alustig3/kicad-libraries/3d/CAS-D20TB.stp

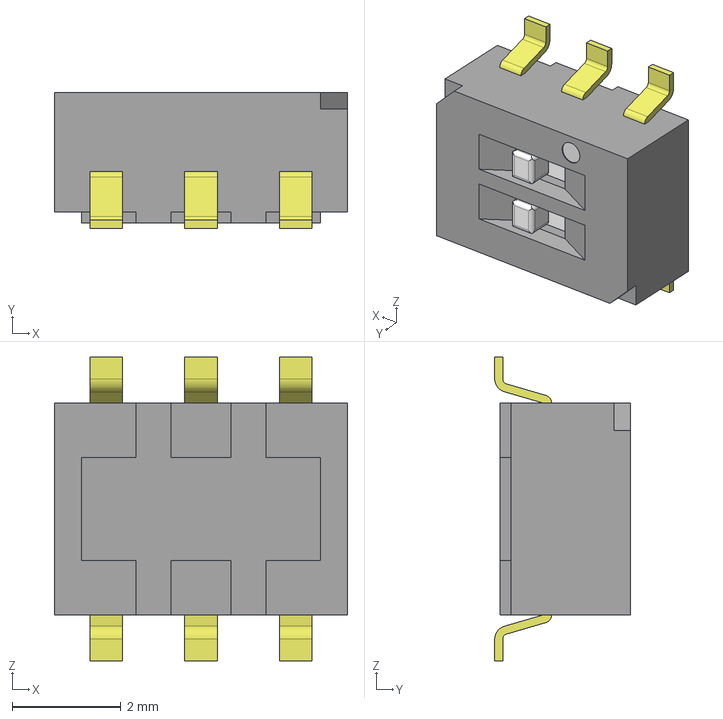
[picture p1: CAD file, 2026-10-02]
3d/CAS-D20TB.stp
5.40 x 2.50 x 5.60 mm
CAS_c_D2B
Dual_s x 2
