alustig3/kicad-libraries/3d/KMR621NGLFS.step

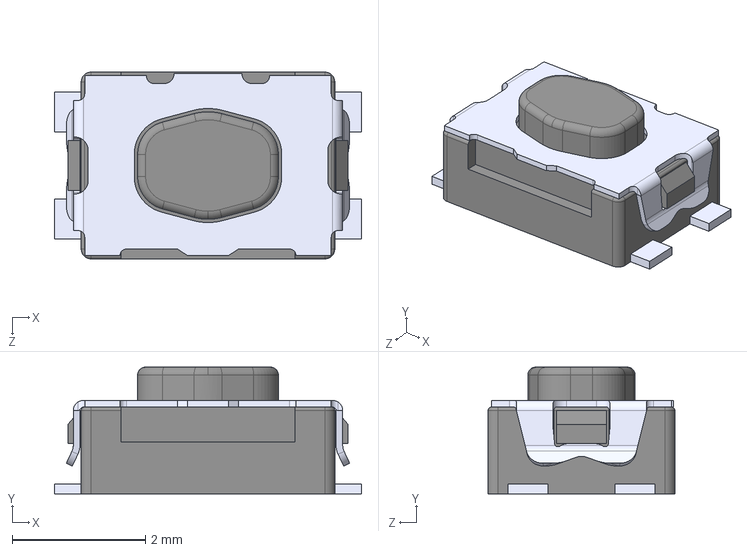
[picture p2: CAD file, 2026-09-30]
3d/KMR621NGLFS.step
4.60 x 1.90 x 2.80 mm
