alustig3/kicad-libraries/3d/7790.step

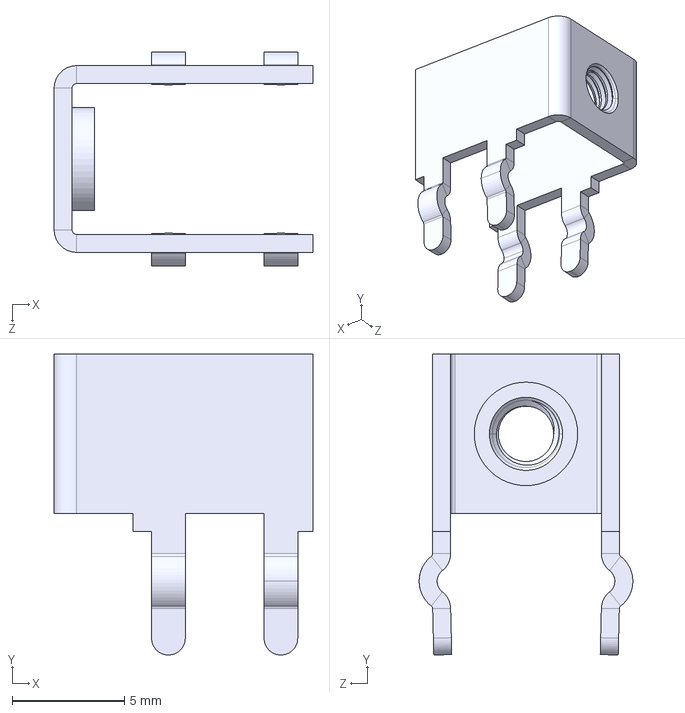
[picture p3: CAD file, 2026-08-19]
3d/7790.step
11.5 x 13.4 x 9.50 mm
