alustig3/kicad-libraries/3d/RA_toggle.step

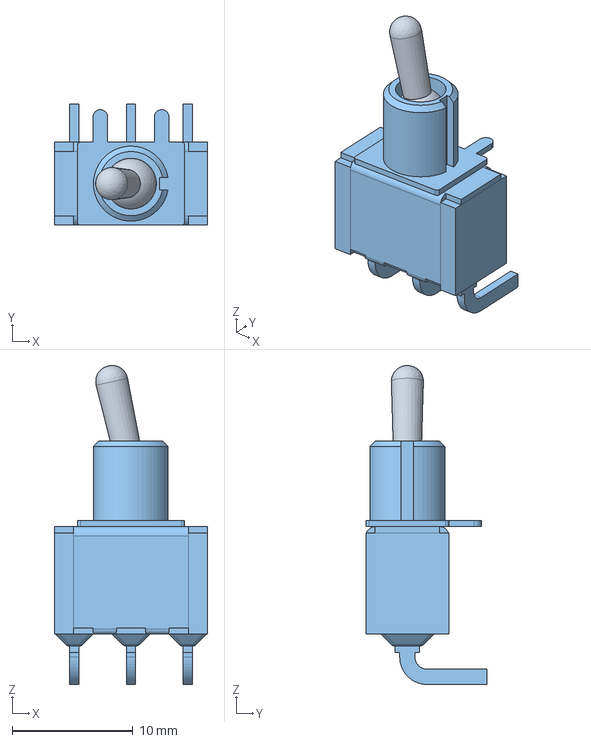
[picture p4: CAD file, 2026-08-18]
3d/RA_toggle.step
12.7 x 10.0 x 26.4 mm
