alustig3/kicad-libraries/3d/TSR 3-2450N.STEP

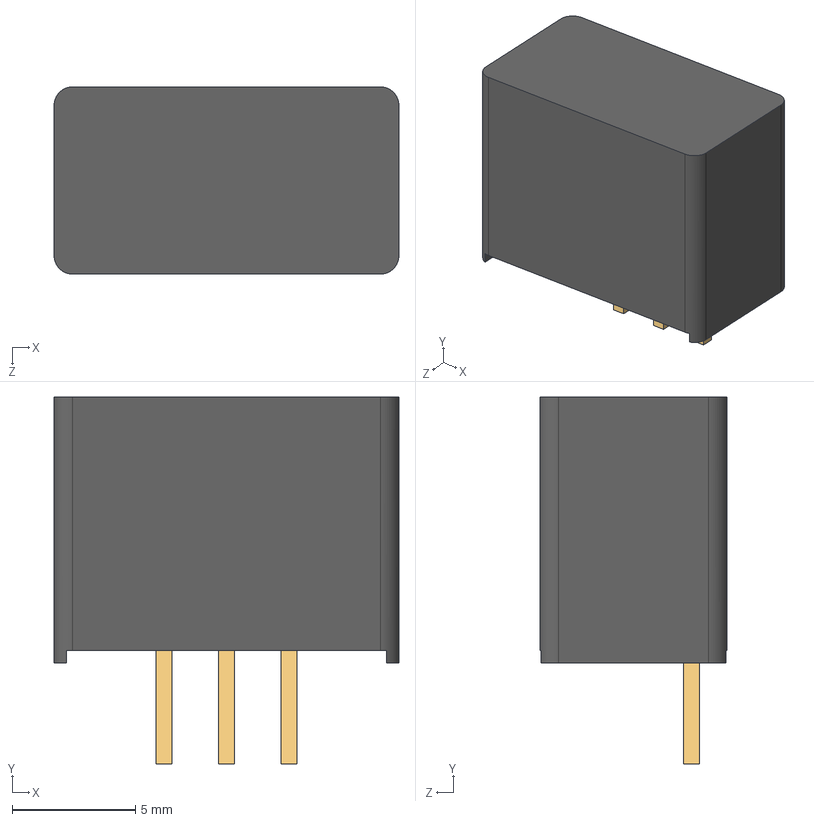
[picture p5: CAD file, 2026-08-18]
3d/TSR 3-2450N.STEP
14.0 x 14.9 x 7.60 mm
CASE-00.stp
__-00.stp
PIN-00.stp x 3
