alustig3/kicad-libraries/3d/W25Q256JVEIQ.STEP

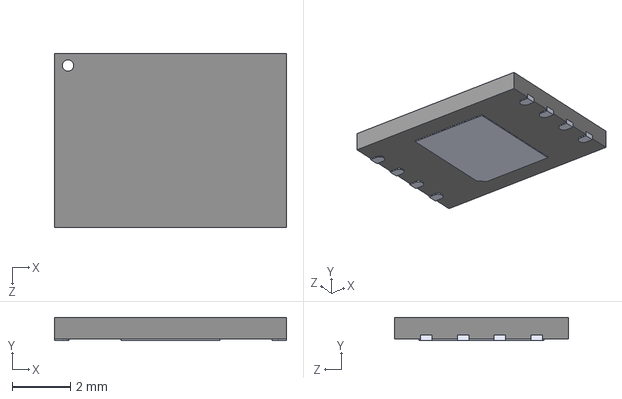
[picture p6: CAD file, 2026-08-05]
3d/W25Q256JVEIQ.STEP
8.00 x 0.8 x 6.00 mm
