alustig3/kicad-libraries/3d/5019.STEP

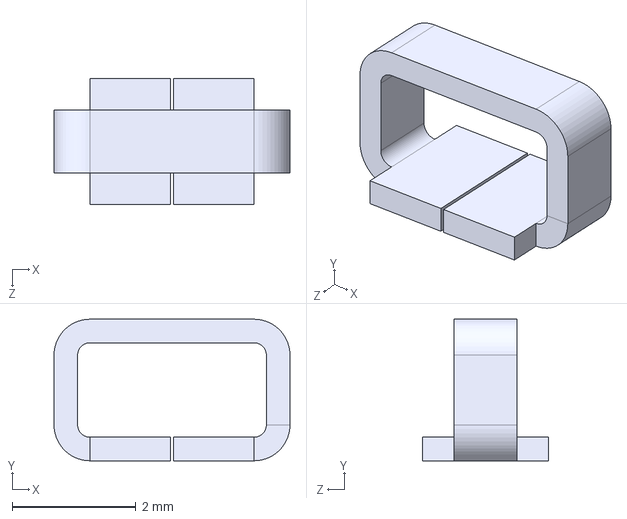
[picture p7: CAD file, 2026-07-16]
3d/5019.STEP
3.81 x 2.29 x 2.03 mm
