alustig3/kicad-libraries/3d/TS02-66-170-BK-260-LCR-D.step

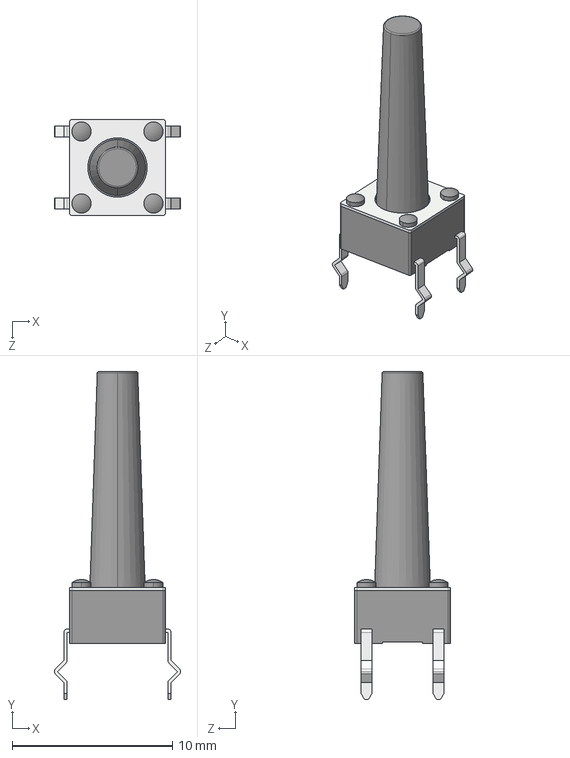
[picture p8: CAD file, 2026-07-08]
3d/TS02-66-170-BK-260-LCR-D.step
7.90 x 20.5 x 6.00 mm
