alustig3/kicad-libraries/3d/RFPC-SMA27-F.step

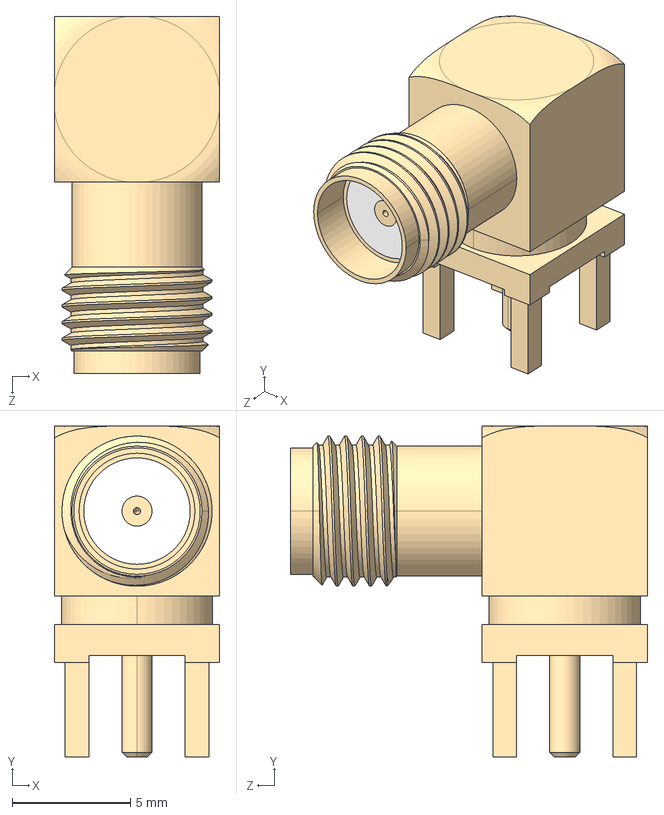
[picture p9: CAD file, 2026-03-03]
3d/RFPC-SMA27-F.step
7.00 x 14.0 x 15.1 mm
