alustig3/kicad-libraries/3d/USB-B1HSB6.STEP

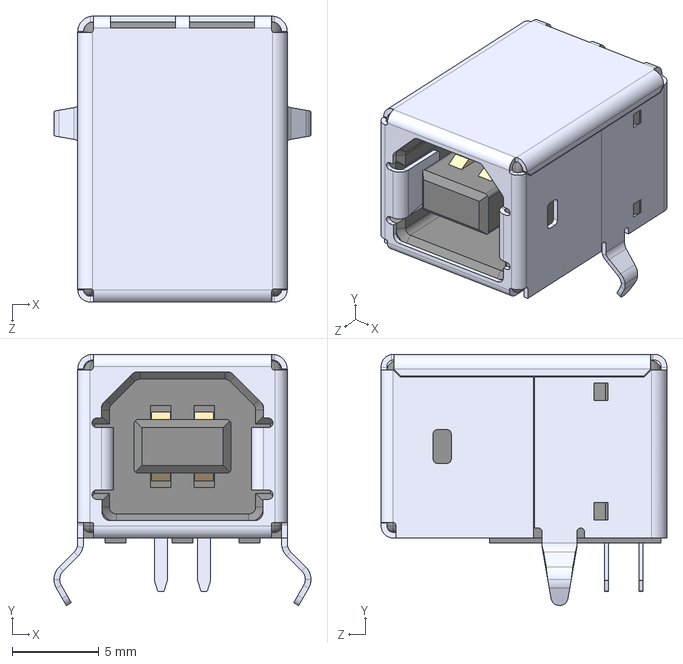
[picture p10: CAD file, 2025-12-22]
3d/USB-B1HSB6.STEP
14.8 x 14.5 x 16.5 mm
