alustig3/kicad-libraries/3d/RJ45_vertical.step

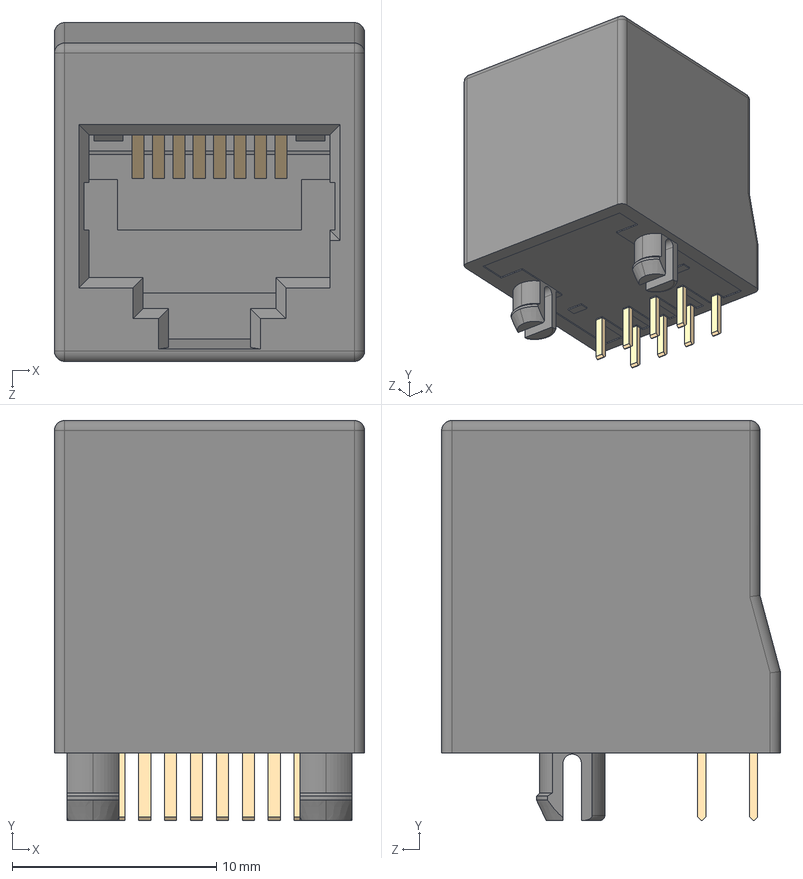
[picture p11: CAD file, 2025-06-04]
3d/RJ45_vertical.step
15.2 x 19.6 x 16.6 mm
