alustig3/kicad-libraries/3d/header_male_16pin.stp

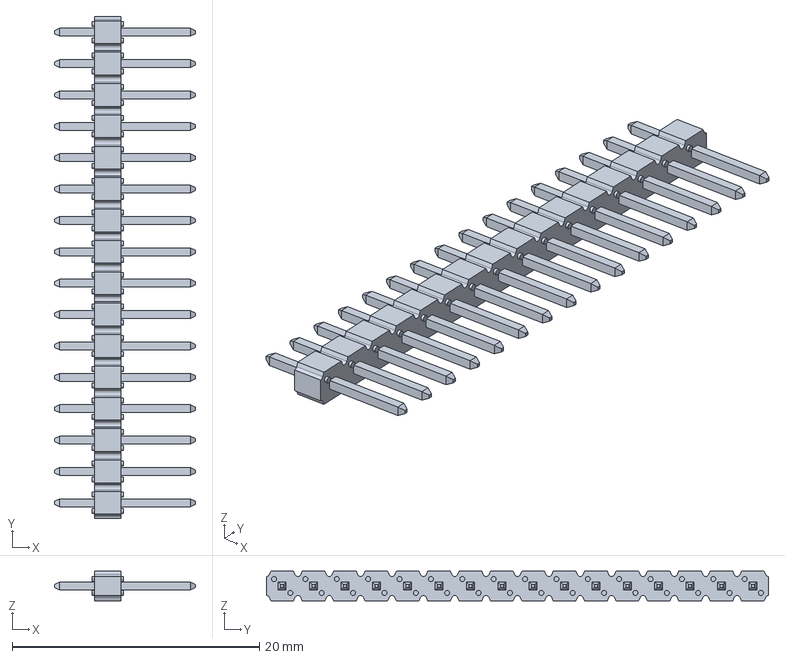
[picture p12: CAD file, 2024-12-18]
3d/header_male_16pin.stp
11.4 x 40.6 x 2.41 mm
