alustig3/kicad-libraries/3d/header_male_10pin.stp

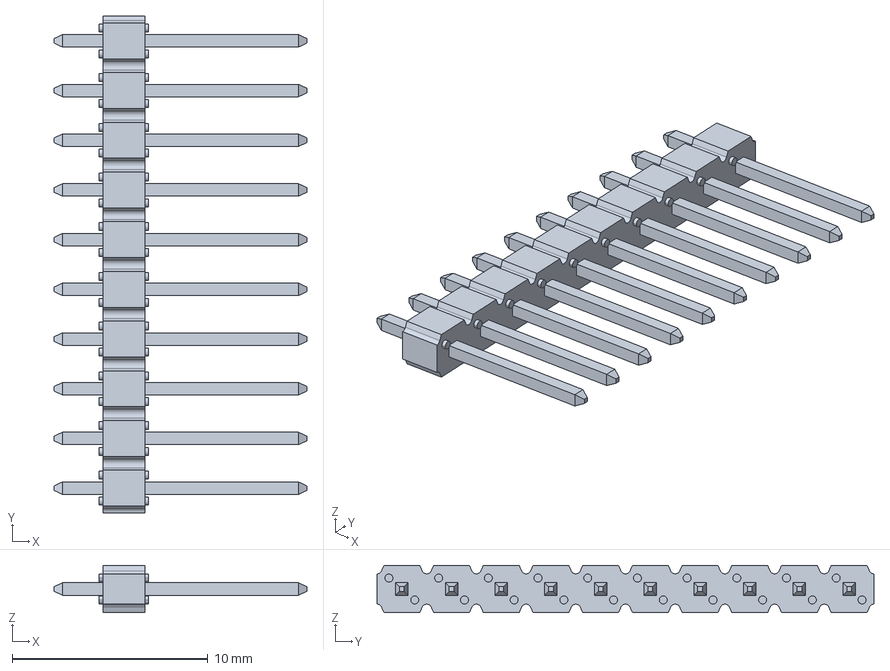
[picture p13: CAD file, 2024-12-18]
3d/header_male_10pin.stp
12.9 x 25.4 x 2.41 mm
