alustig3/kicad-libraries/3d/header_female_10pos.STEP

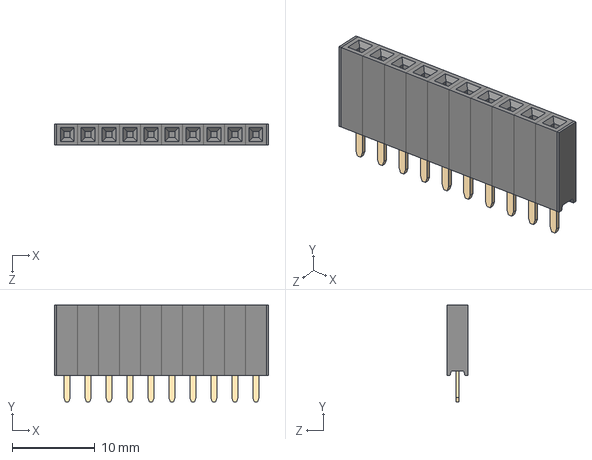
[picture p14: CAD file, 2024-12-18]
3d/header_female_10pos.STEP
25.9 x 11.7 x 2.54 mm
PPPC021LFBN-RC_C10
Pin - Gold x 10
