alustig3/kicad-libraries/3d/header_female_16pos.STEP

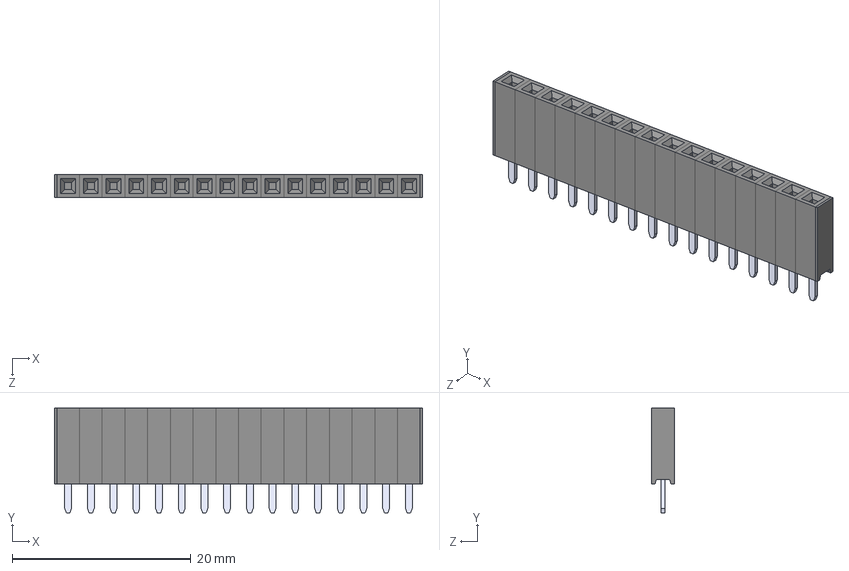
[picture p15: CAD file, 2024-12-18]
3d/header_female_16pos.STEP
41.1 x 11.7 x 2.54 mm
PPPC021LFBN-RC_C16
Pin - Tin x 16
