alustig3/kicad-libraries/3d/CP2102N-A02-GQFN20R.step

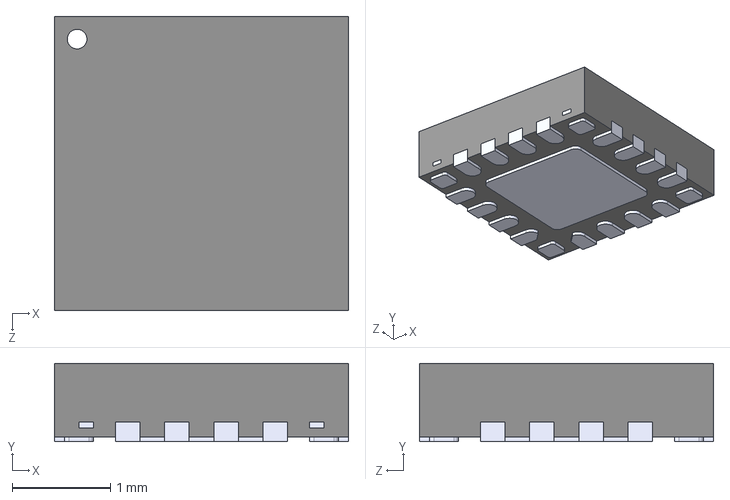
[picture p16: CAD file, 2024-12-13]
3d/CP2102N-A02-GQFN20R.step
3.00 x 0.8 x 3.00 mm
