alustig3/kicad-libraries/3d/s3_reverse_tft_feather.step

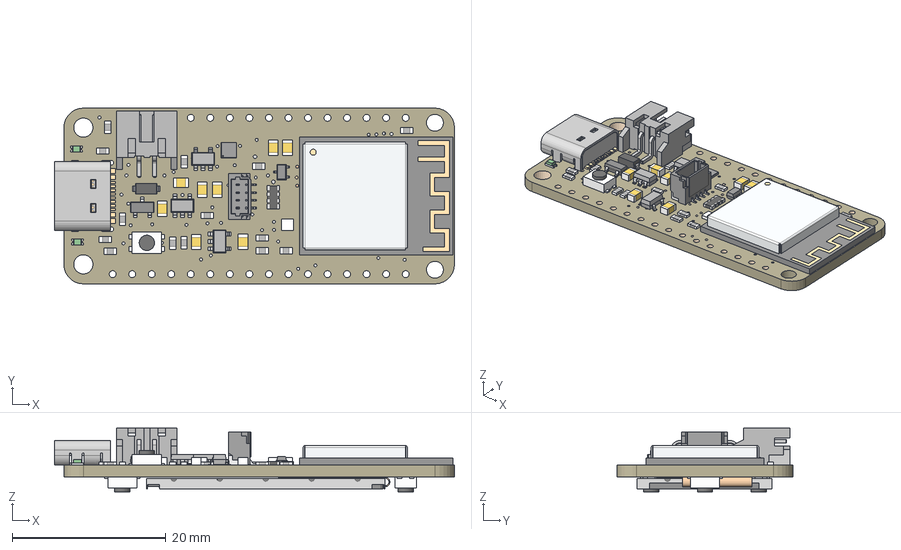
[picture p17: CAD file, 2024-10-28]
3d/s3_reverse_tft_feather.step
52.0 x 22.9 x 8.27 mm
Board
10uF x 8
RT9080/AP2112-3.3 x 2
MBR540
JSTPH
MCP73831T-2ACI/OT
RED x 2
1uF x 14
KMR2 x 5
DMG3415U
USB C
ESP32-S3-MINI-1
STEMMA_I2C_QTRA
WS2812B_SK6805_1515
DISP_LCD_GENERIC_SPI_1.14IN_240X135_WRAPUNDER
BSS138
10K Pack
MAX17048/T
