alustig3/kicad-libraries/3d/S6B-PH-SM4-TB.STEP

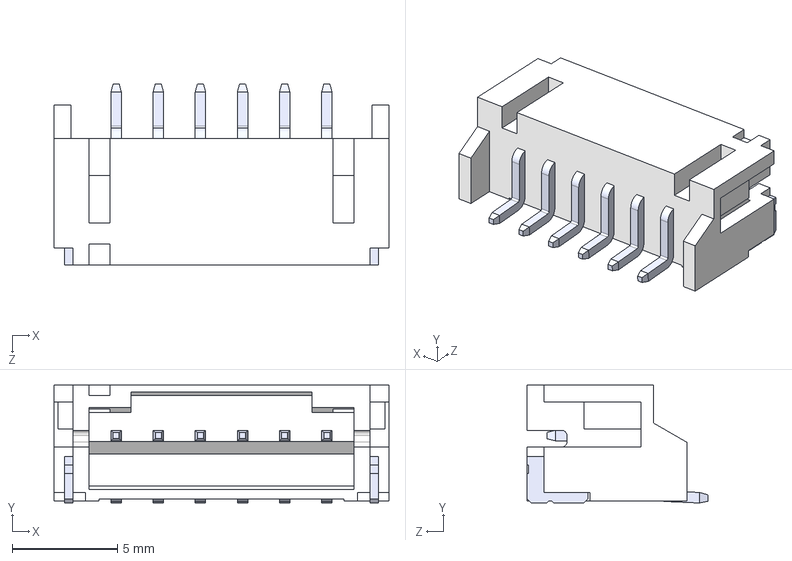
[picture p18: CAD file, 2024-09-23]
3d/S6B-PH-SM4-TB.STEP
15.9 x 5.60 x 8.60 mm
