alustig3/kicad-libraries/3d/B6B-PH-SM4-TB.step

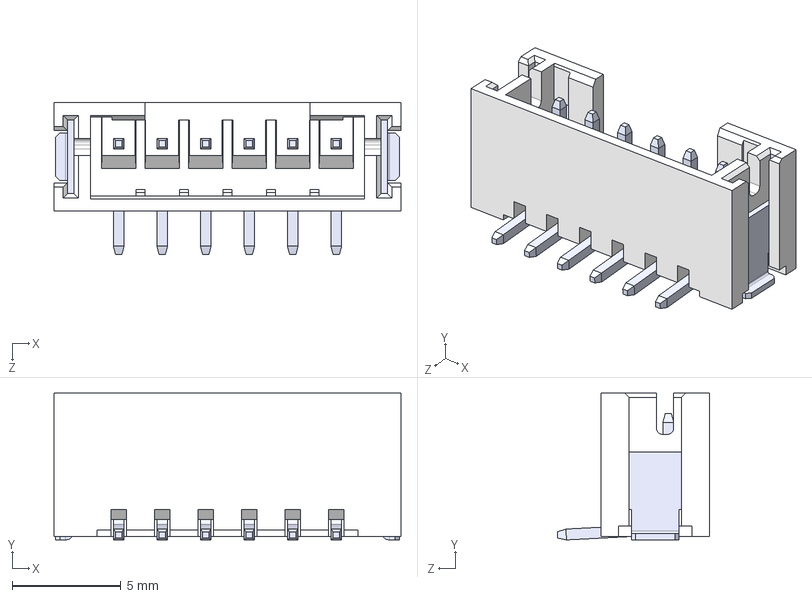
[picture p19: CAD file, 2024-09-03]
3d/B6B-PH-SM4-TB.step
15.9 x 6.75 x 7.00 mm
BxB-PH-SM4 body_6
BxB-PH-SM4 tab x 2
BxB-PH-SM4 pin x 6
