alustig3/kicad-libraries/3d/LBA716STR.step

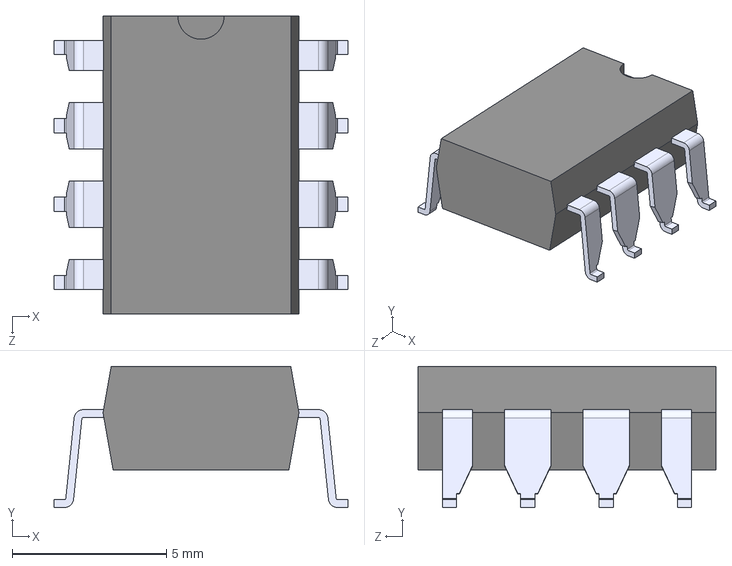
[picture p20: CAD file, 2024-08-30]
3d/LBA716STR.step
9.53 x 4.57 x 9.65 mm
