alustig3/kicad-libraries/3d/E5J88-00LJG2-L.stp

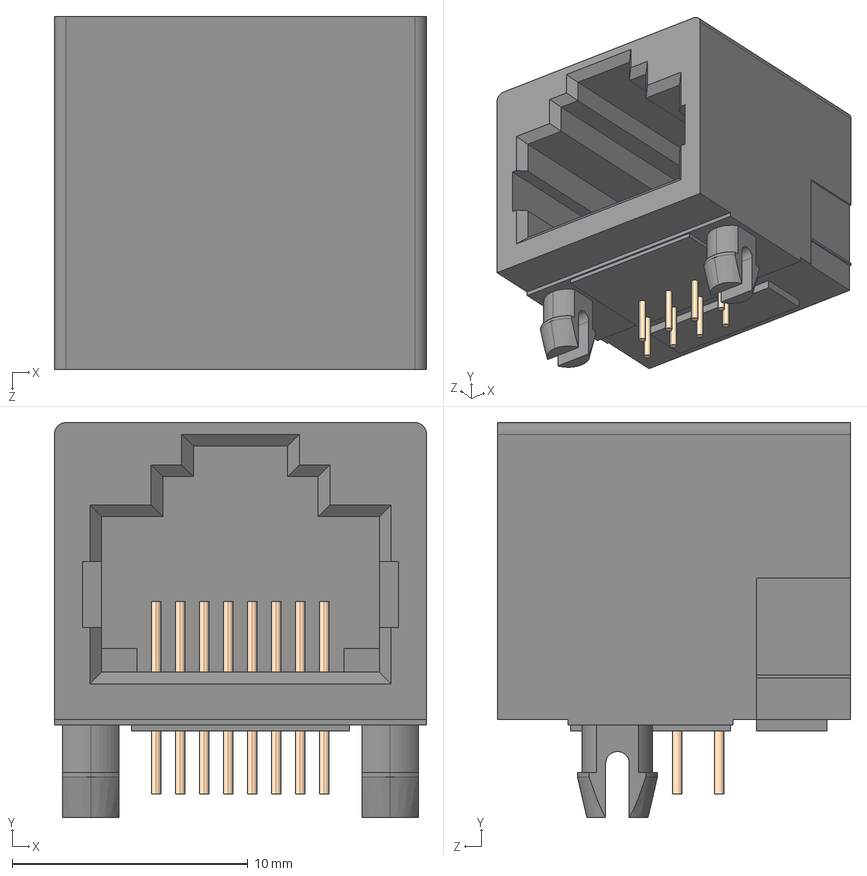
[picture p21: CAD file, 2024-08-30]
3d/E5J88-00LJG2-L.stp
15.8 x 16.8 x 15.0 mm
