alustig3/kicad-libraries/3d/3-2106431-4.step

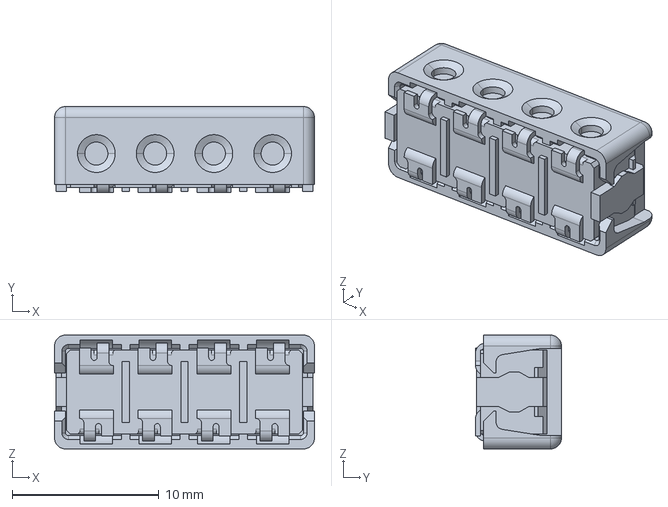
[picture p22: CAD file, 2024-07-26]
3d/3-2106431-4.step
17.7 x 5.85 x 7.75 mm
