alustig3/kicad-libraries/3d/ESE-22MV21T.step

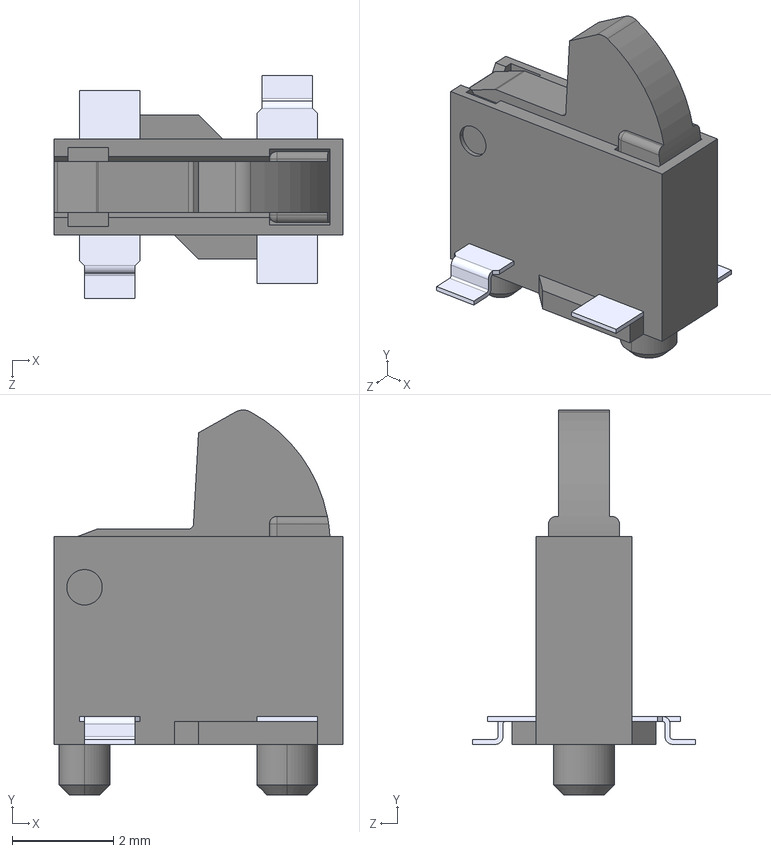
[picture p23: CAD file, 2024-07-18]
3d/ESE-22MV21T.step
5.70 x 7.60 x 4.40 mm
