alustig3/kicad-libraries/3d/SS-641010-A-NF-A111.stp

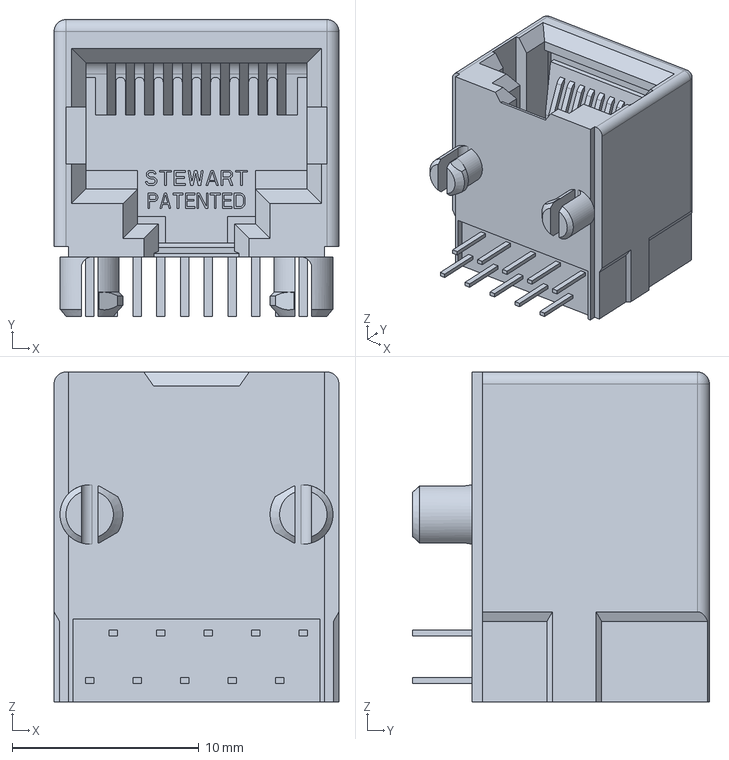
[picture p24: CAD file, 2024-06-14]
3d/SS-641010-A-NF-A111.stp
15.2 x 15.9 x 17.7 mm
