alustig3/kicad-libraries/3d/SS-651010-A-NF.stp

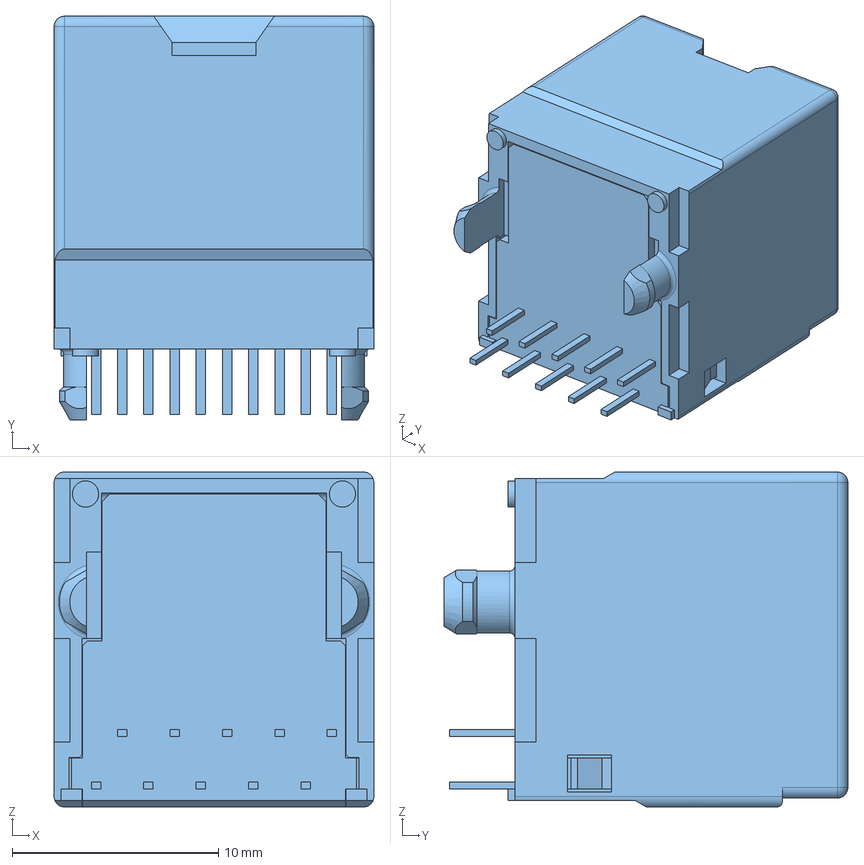
[picture p25: CAD file, 2024-06-12]
3d/SS-651010-A-NF.stp
15.5 x 19.6 x 16.2 mm
SS-651010-A-NF_PART1
SS-651010-A-NF_PART2
SS-651010-A-NF_PART3
SS-651010-A-NF_PART4
