alustig3/kicad-libraries/3d/NR3015T4R7M.STEP

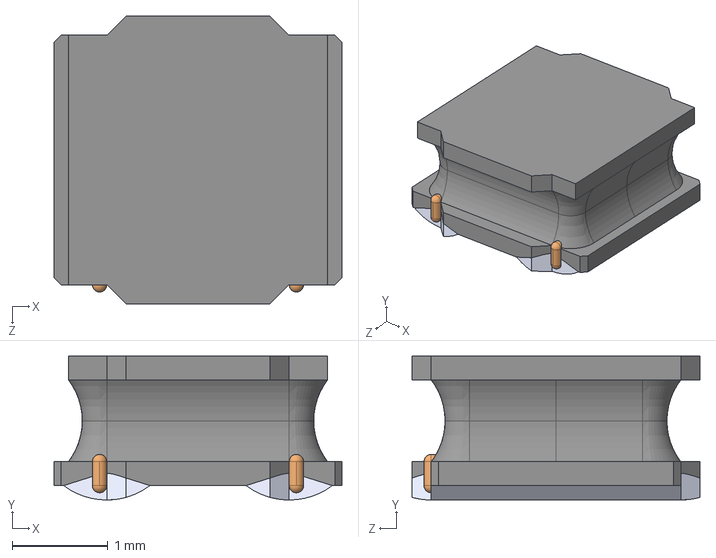
[picture p26: CAD file, 2024-06-10]
3d/NR3015T4R7M.STEP
3.00 x 1.50 x 3.00 mm
