alustig3/kicad-libraries/3d/VZ43FM1B8230001L.stp

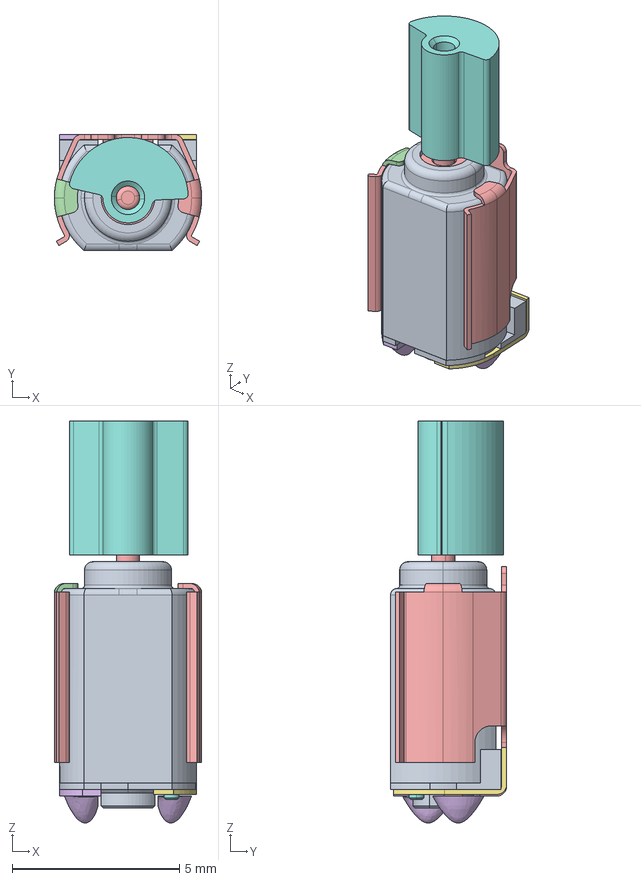
[picture p27: CAD file, 2024-03-14]
3d/VZ43FM1B8230001L.stp
4.40 x 3.48 x 12.0 mm
N-20907
N-8992
_R1_8_000
