alustig3/kicad-libraries/3d/12mm_tactile.stp

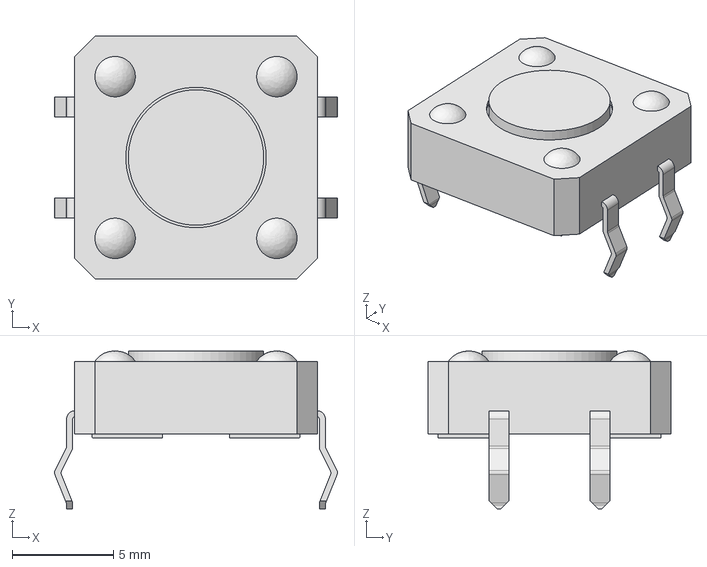
[picture p28: CAD file, 2023-07-20]
3d/12mm_tactile.stp
14.0 x 12.0 x 7.80 mm
