alustig3/kicad-libraries/3d/IDC_2x06_1.27.stp

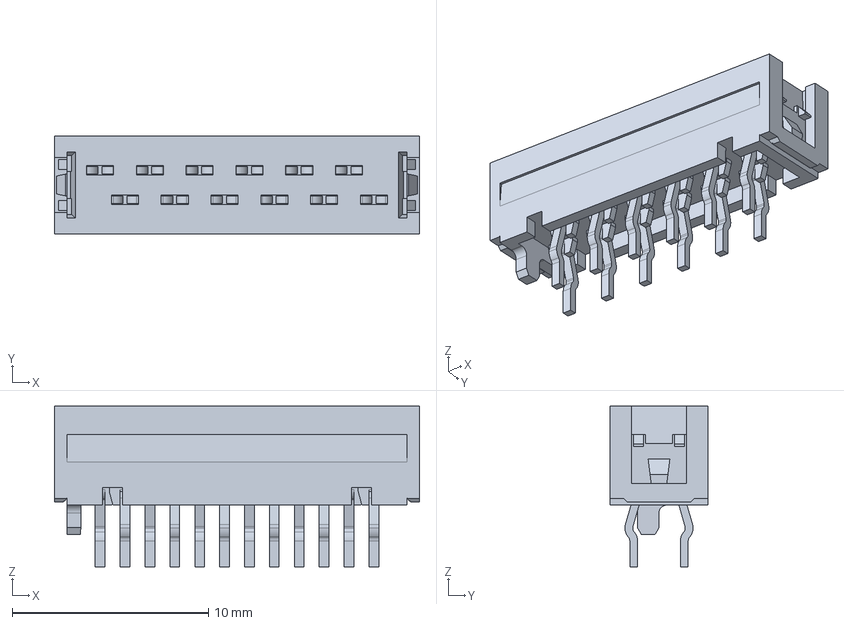
[picture p29: CAD file, 2023-06-05]
3d/IDC_2x06_1.27.stp
18.6 x 5.00 x 8.20 mm
