alustig3/kicad-libraries/3d/PB86.step

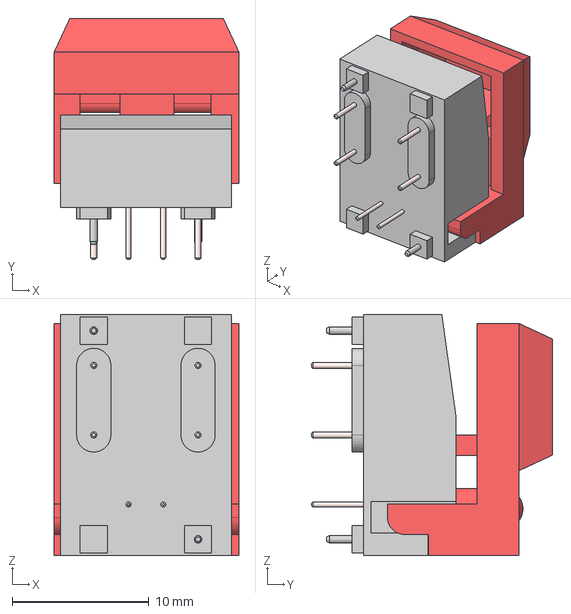
[picture p31: CAD file, 2023-01-10]
3d/PB86.step
13.5 x 17.6 x 17.6 mm
