alustig3/kicad-libraries/3d/BM4B-SRSS-TB.step

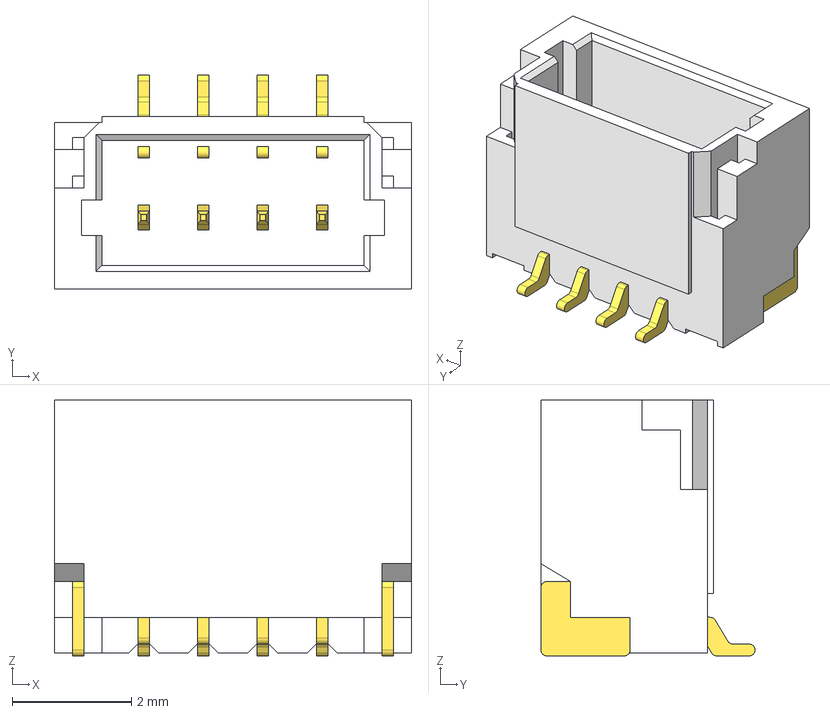
[picture p32: CAD file, 2023-01-10]
3d/BM4B-SRSS-TB.step
6.00 x 3.60 x 4.30 mm
