alustig3/kicad-libraries/3d/M2011SS1W03.stp

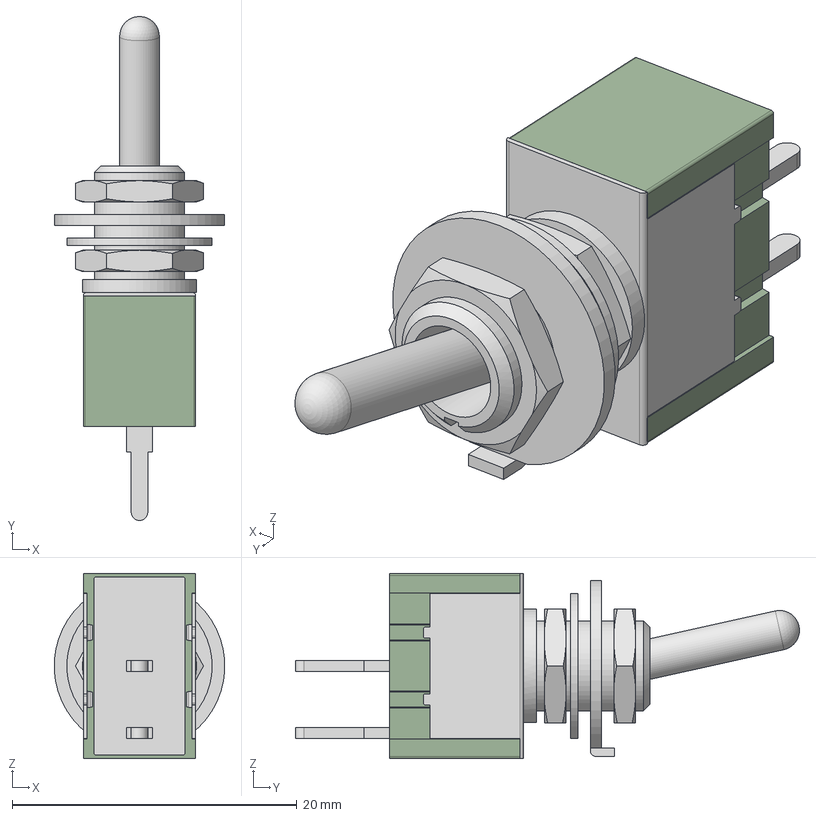
[picture p33: CAD file, 2023-01-03]
3d/M2011SS1W03.stp
12.0 x 35.4 x 13.0 mm
M20S-caps
M20S-toggles
M201103-terminals
AT513H x 2
AT509
AT507H
M201S1M201-bushing
M20111SS1W03-switch
