alustig3/kicad-libraries/3d/4_digit_7_segment_56.step

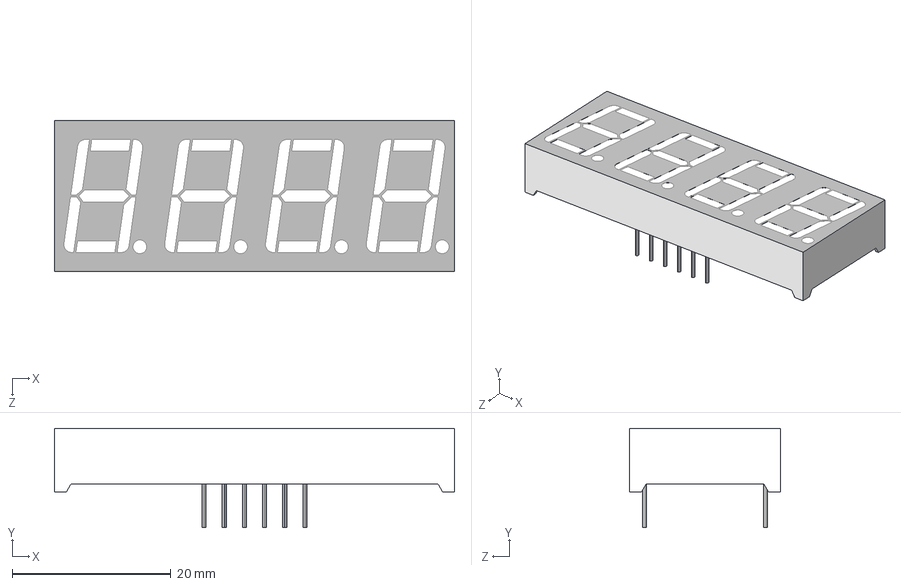
[picture p34: CAD file, 2022-12-31]
3d/4_digit_7_segment_56.step
50.4 x 12.5 x 19.0 mm
