alustig3/kicad-libraries/3d/CMI-1275C-050.step

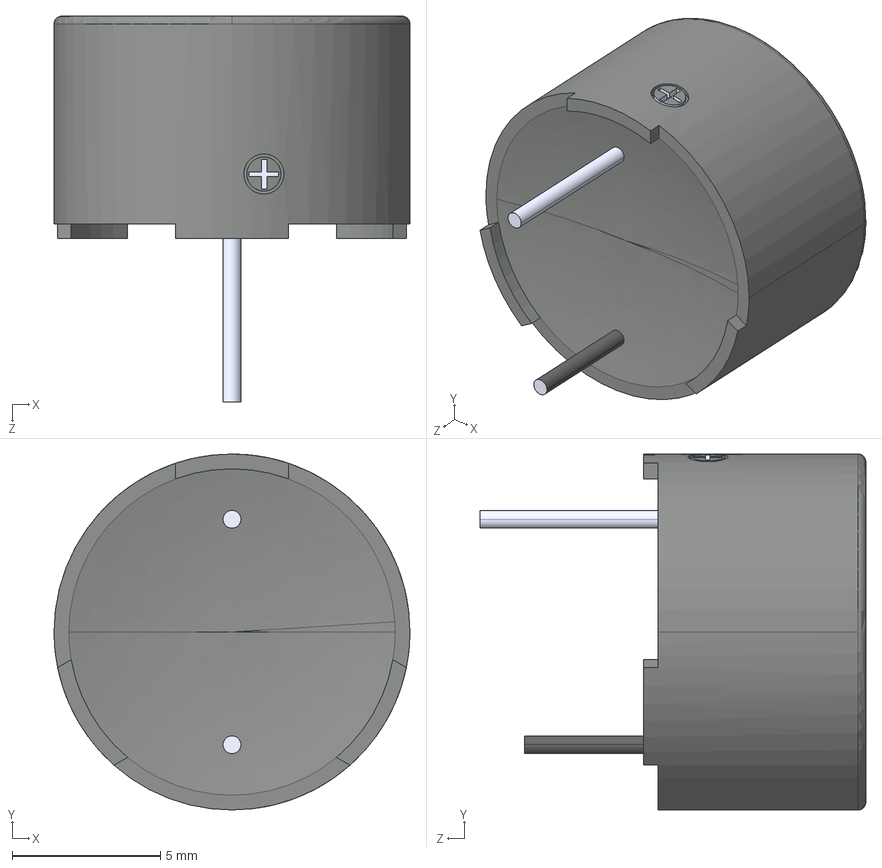
[picture p35: CAD file, 2022-12-31]
3d/CMI-1275C-050.step
12.0 x 12.0 x 13.0 mm
___SHELL-1
___SHELL-2
___SHELL-3
