alustig3/kicad-libraries/3d/reverse_led_bigger.step

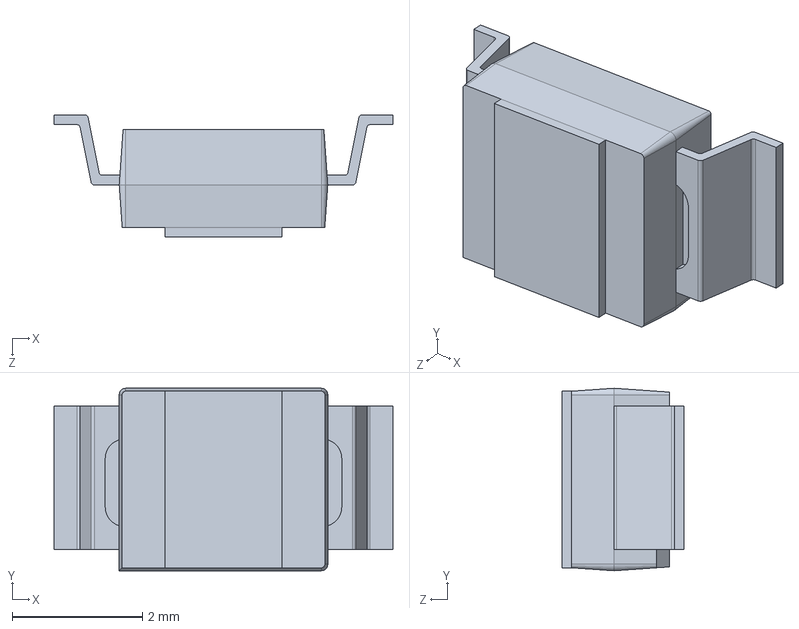
[picture p36: CAD file, 2022-12-05]
3d/reverse_led_bigger.step
5.20 x 2.80 x 1.87 mm
