alustig3/kicad-libraries/3d/IDC_02x04.step

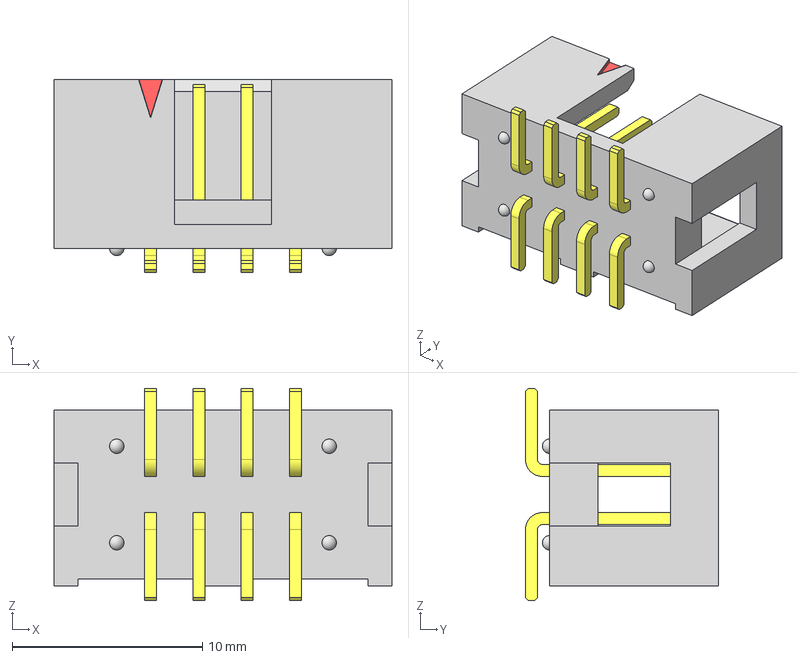
[picture p37: CAD file, 2022-12-05]
3d/IDC_02x04.step
17.8 x 10.2 x 11.2 mm
T-1S6-04-01-DV_
HTST-First_Position_Indicator
HTST-104-01-DV_header
