alustig3/kicad-libraries/3d/JST-S2B-PH-SM4.step

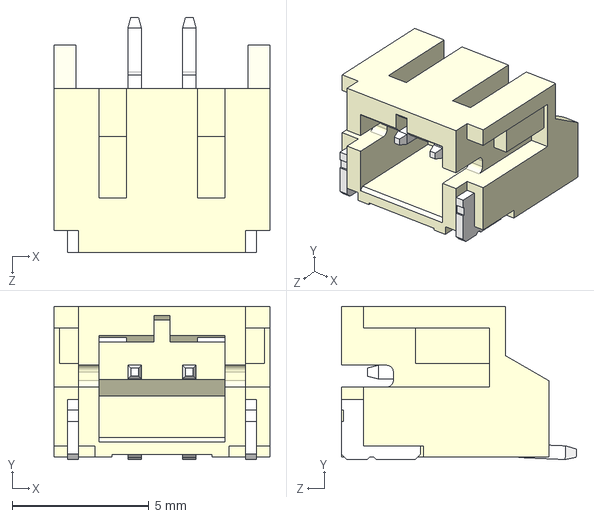
[picture p38: CAD file, 2022-08-28]
3d/JST-S2B-PH-SM4.step
7.90 x 5.60 x 8.60 mm
