alustig3/kicad-libraries/3d/horz usb.step

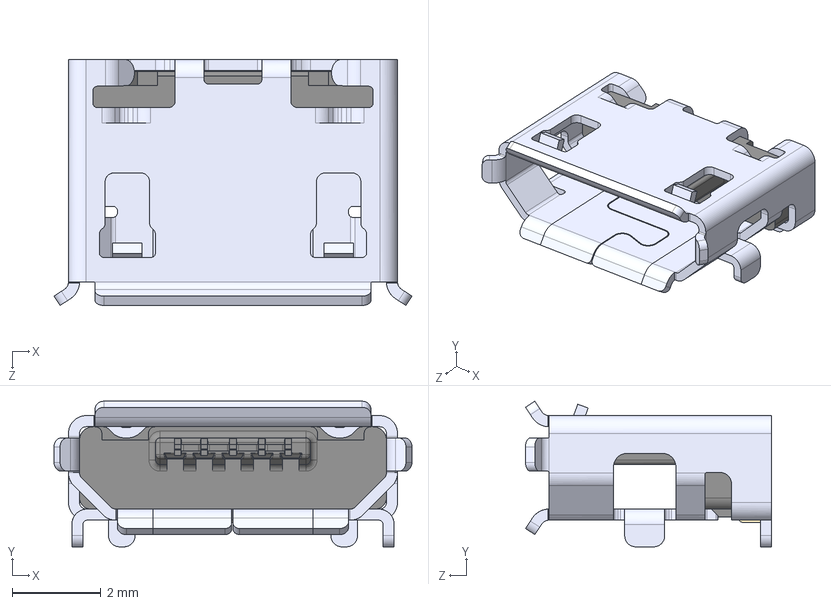
[picture p39: CAD file, 2022-07-14]
3d/horz usb.step
8.05 x 3.27 x 5.53 mm
