alustig3/kicad-libraries/3d/diode_powermite.step

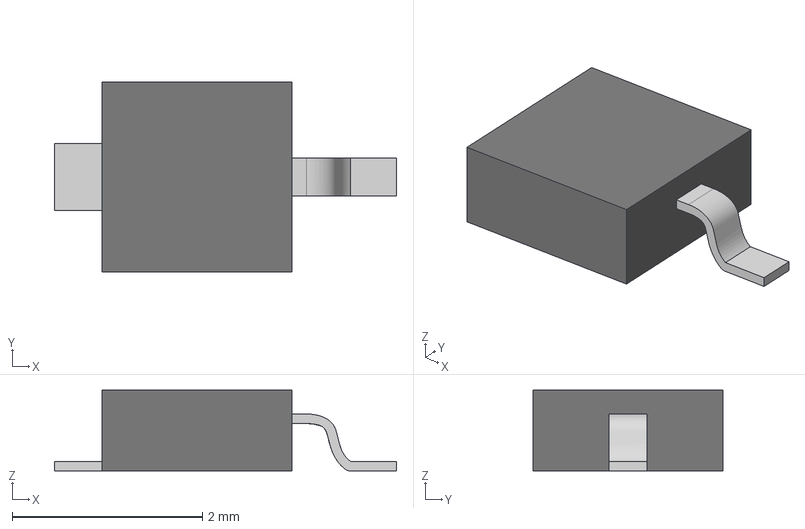
[picture p40: CAD file, 2022-07-14]
3d/diode_powermite.step
3.60 x 2.00 x 0.85 mm
