alustig3/kicad-libraries/3d/resonator.step

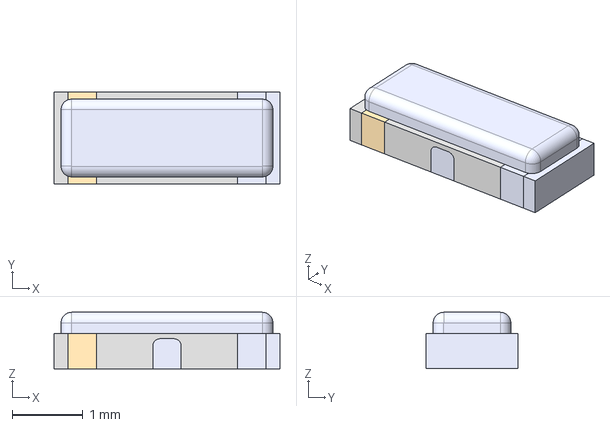
[picture p41: CAD file, 2022-07-14]
3d/resonator.step
3.20 x 1.30 x 0.8 mm
