alustig3/kicad-libraries/3d/qtpy_esp32s2.step

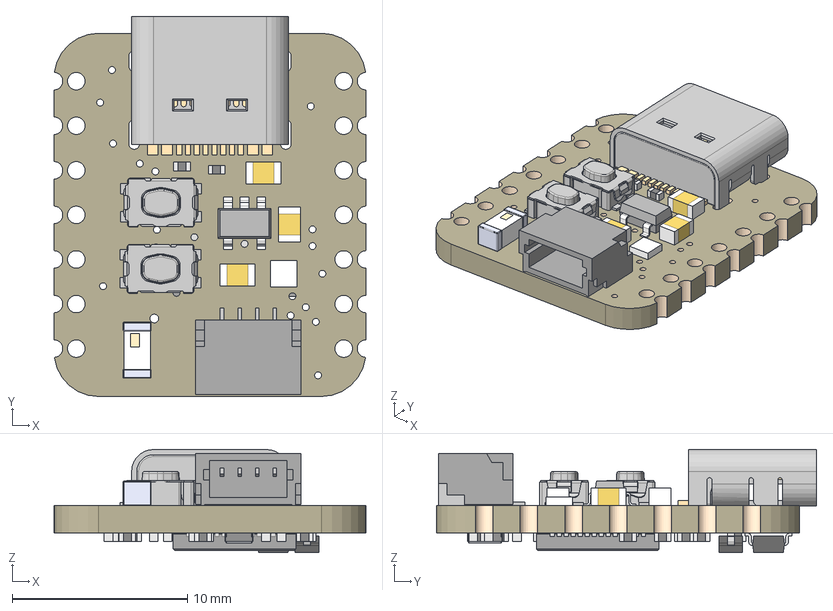
[picture p42: CAD file, 2022-06-01]
3d/qtpy_esp32s2.step
17.8 x 21.7 x 5.87 mm
Board
22uF x 3
BOOT0 x 2
1uF x 23
USB TYPE C
STEMMA_I2C_QTSKINNY
AP2112K-3.3
WS2812B_SK6805_1515
NSR0320 x 2
ESP32-S2QFN54
0 ohm x 2
40MHz
ANT_2450AT18B100
TPB1,27 x 2
