alustig3/kicad-libraries/3d/PEC11R-4X15F-S.step

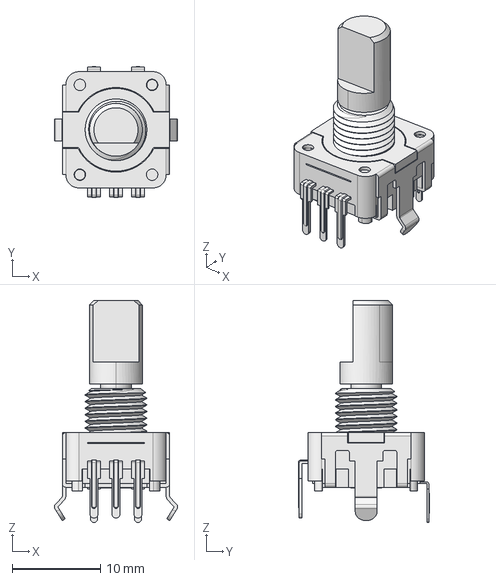
[picture p44: CAD file, 2022-04-08]
3d/PEC11R-4X15F-S.step
14.0 x 14.9 x 25.2 mm
