alustig3/kicad-libraries/3d/VL6180X.step

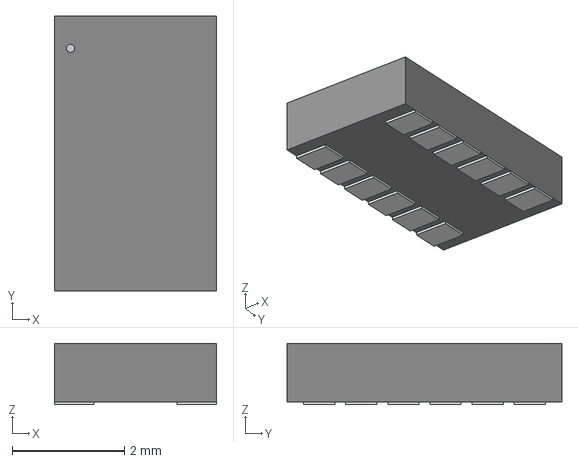
[picture p45: CAD file, 2021-12-10]
3d/VL6180X.step
2.90 x 4.90 x 1.09 mm
