alustig3/kicad-libraries/3d/SSOP5_ROM.step

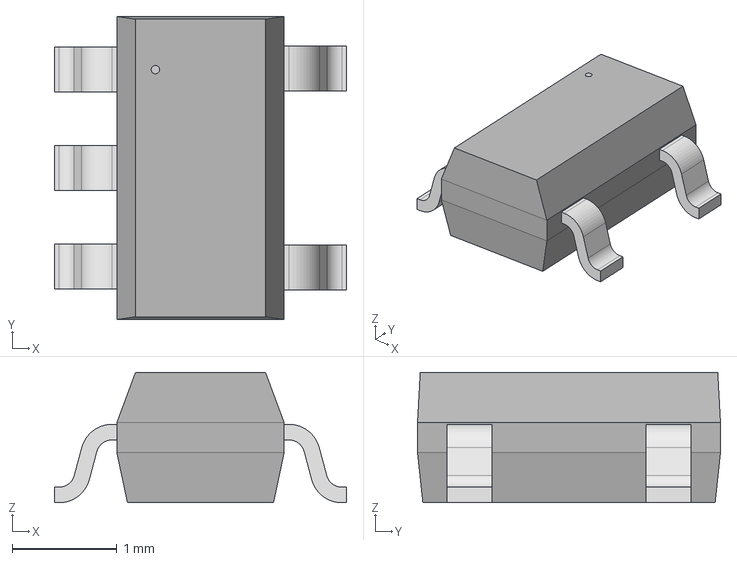
[picture p46: CAD file, 2021-12-08]
3d/SSOP5_ROM.step
2.79 x 2.90 x 1.25 mm
