alustig3/kicad-libraries/3d/laser_diode_56.step

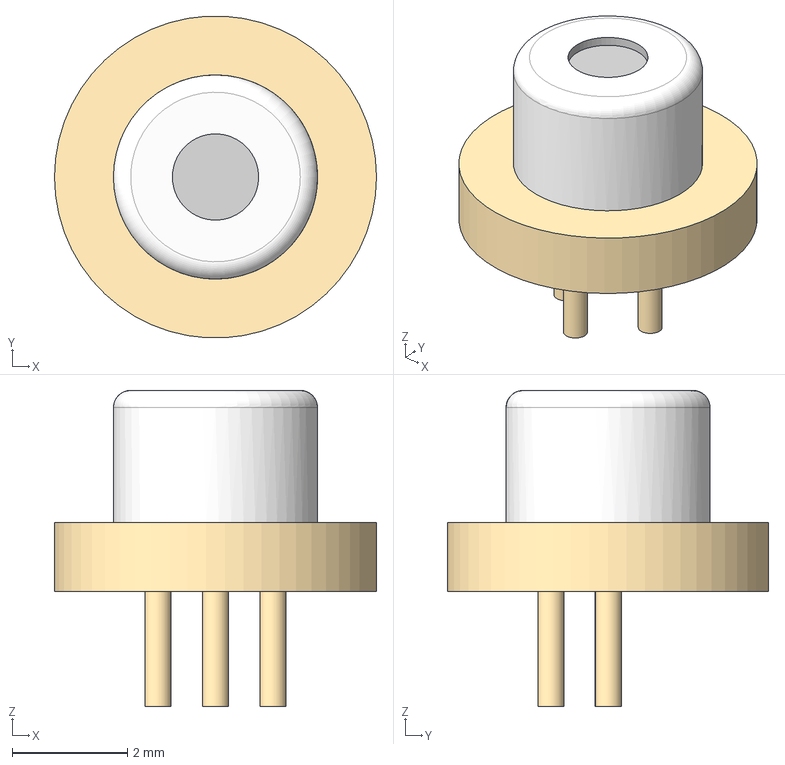
[picture p47: CAD file, 2021-07-08]
3d/laser_diode_56.step
5.60 x 5.59 x 5.50 mm
