alustig3/kicad-libraries/3d/usb_vertical_socket.step

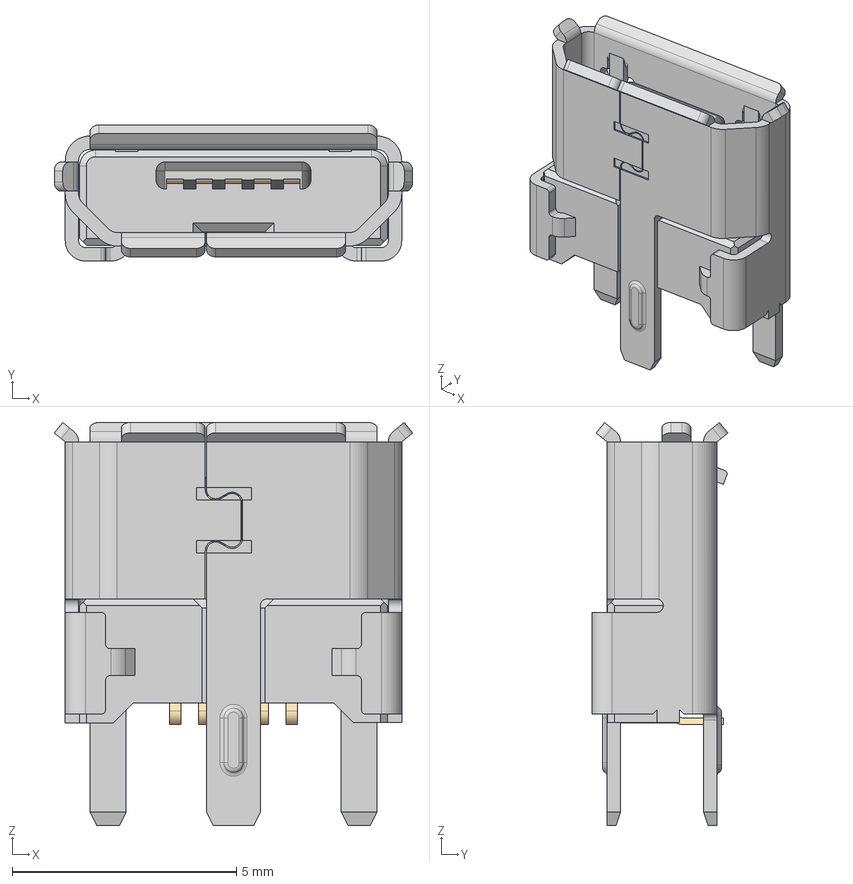
[picture p48: CAD file, 2021-07-08]
3d/usb_vertical_socket.step
7.99 x 3.03 x 8.98 mm
