alustig3/kicad-libraries/3d/RFM69HCW_315S060_cp.step

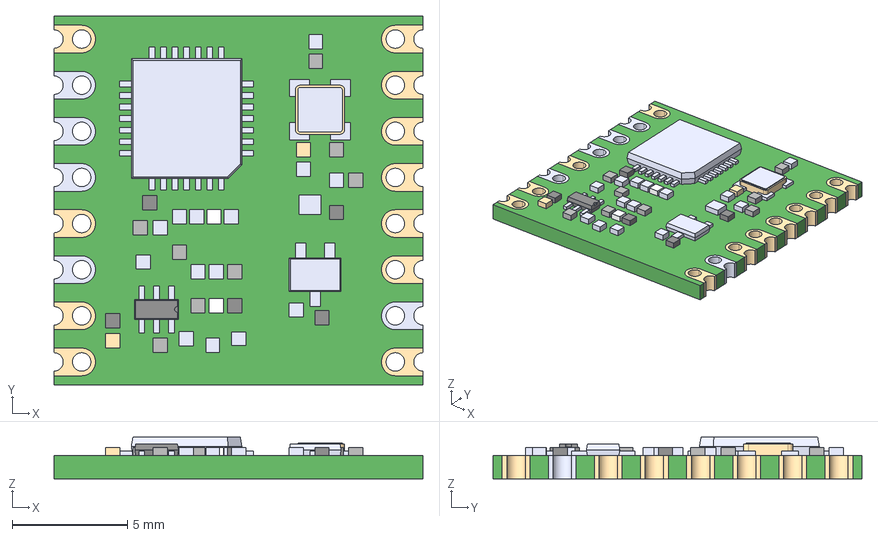
[picture p49: CAD file, 2021-07-07]
3d/RFM69HCW_315S060_cp.step
16.0 x 16.0 x 1.80 mm
