alustig3/kicad-libraries/3d/usb_vertical_plug.step

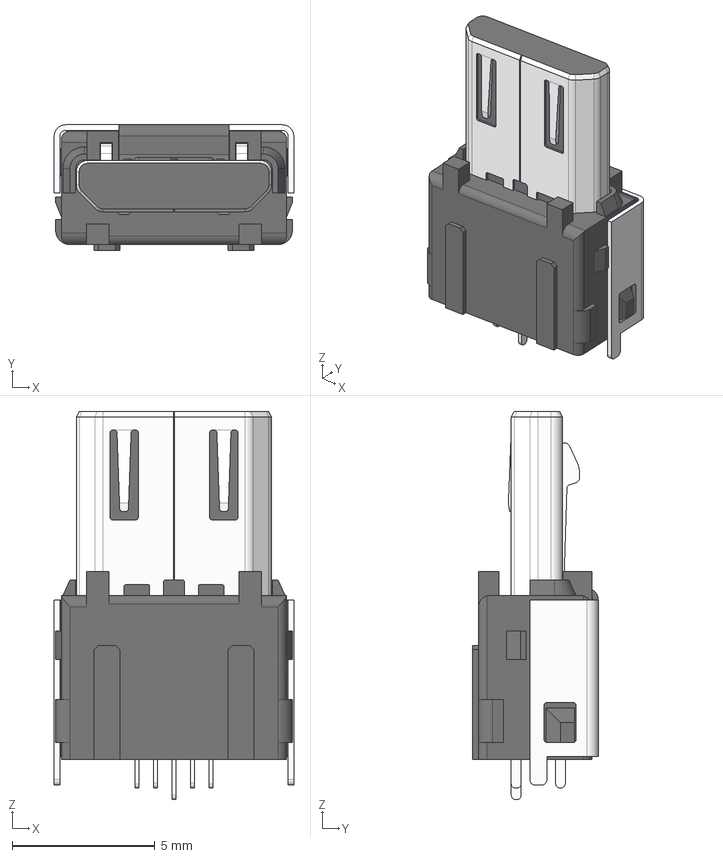
[picture p50: CAD file, 2021-07-03]
3d/usb_vertical_plug.step
8.40 x 4.40 x 13.6 mm
