alustig3/kicad-libraries/3d/2pin_microlock.step

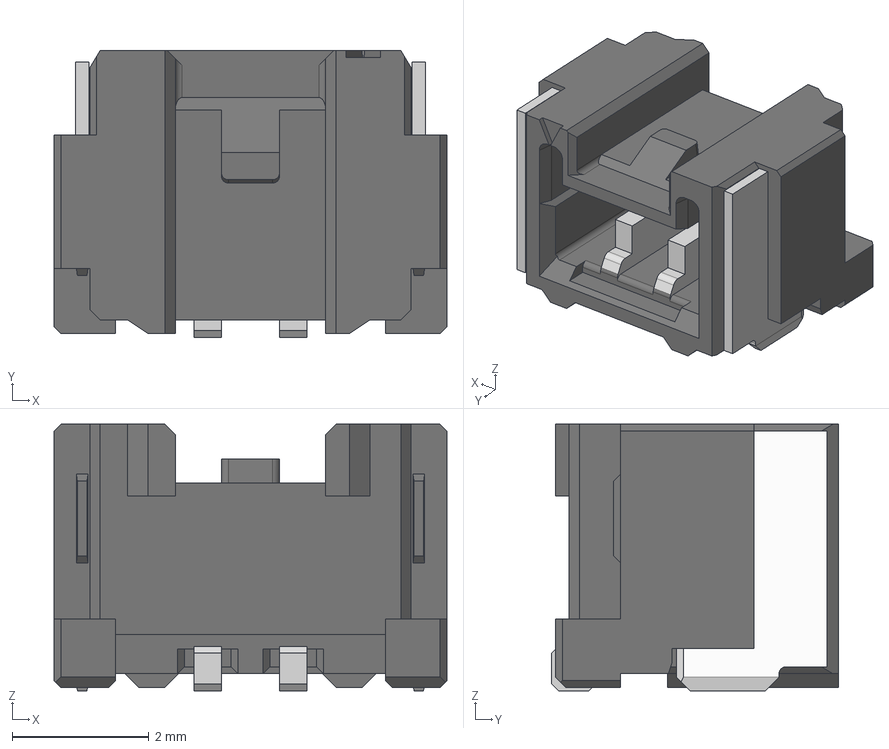
[picture p51: CAD file, 2021-07-03]
3d/2pin_microlock.step
5.75 x 4.20 x 3.90 mm
