alustig3/kicad-libraries/3d/LQH43CN100K03.step

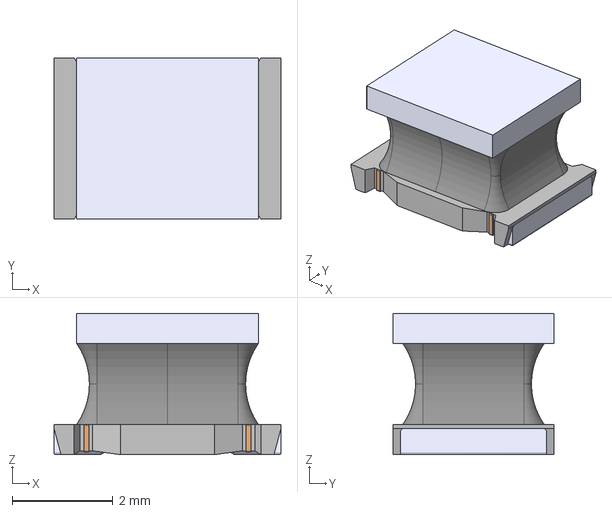
[picture p52: CAD file, 2021-07-02]
3d/LQH43CN100K03.step
4.50 x 3.20 x 2.80 mm
