alustig3/kicad-libraries/3d/PCM12SMTR.step

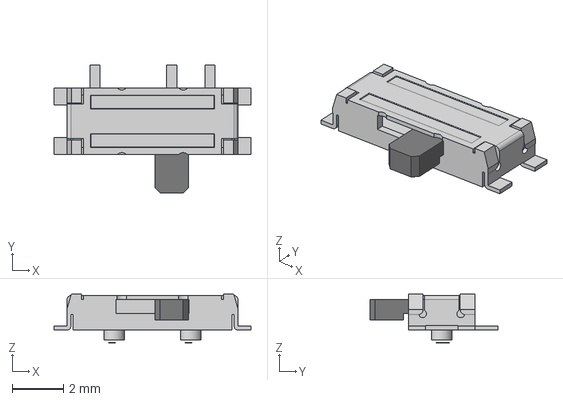
[picture p53: CAD file, 2021-07-02]
3d/PCM12SMTR.step
7.70 x 5.00 x 1.90 mm
