alustig3/kicad-libraries/3d/b3u-1000p.step

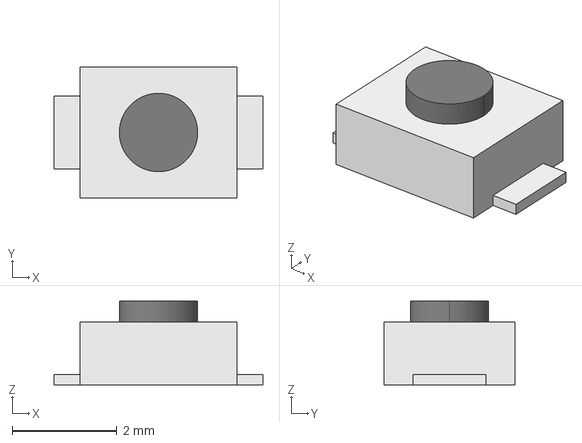
[picture p54: CAD file, 2021-07-02]
3d/b3u-1000p.step
4.00 x 2.50 x 1.60 mm
