alustig3/kicad-libraries/3d/vertical RJ45 v1.step

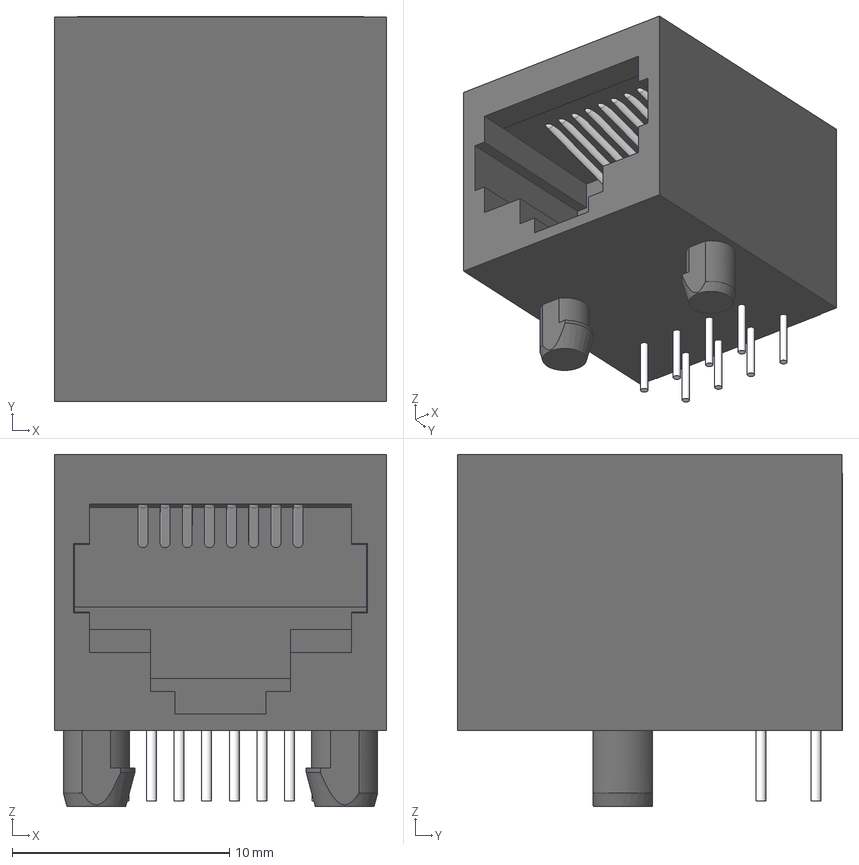
[picture p55: CAD file, 2021-06-17]
3d/vertical RJ45 v1.step
15.3 x 17.7 x 16.2 mm
