alustig3/kicad-libraries/3d/switch_reinforced_pc_pin.step

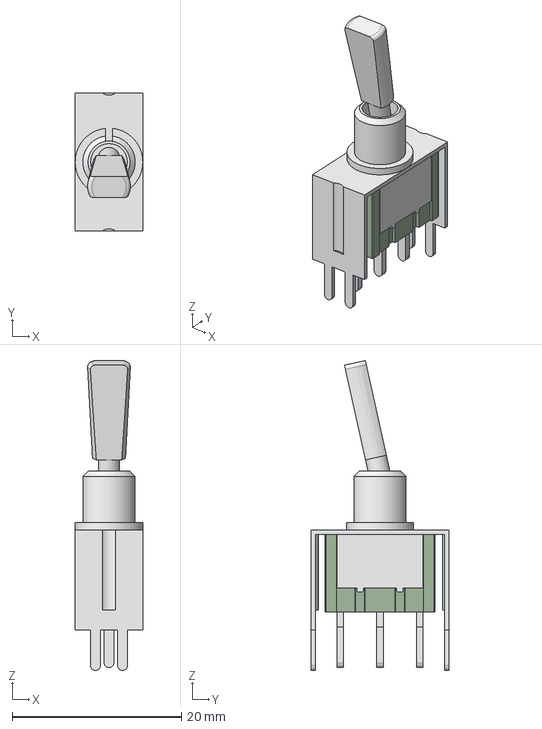
[picture p56: CAD file, 2021-02-09]
3d/switch_reinforced_pc_pin.step
8.00 x 16.3 x 36.7 mm
