alustig3/kicad-libraries/3d/SW_Cherry_MX_PCB.step

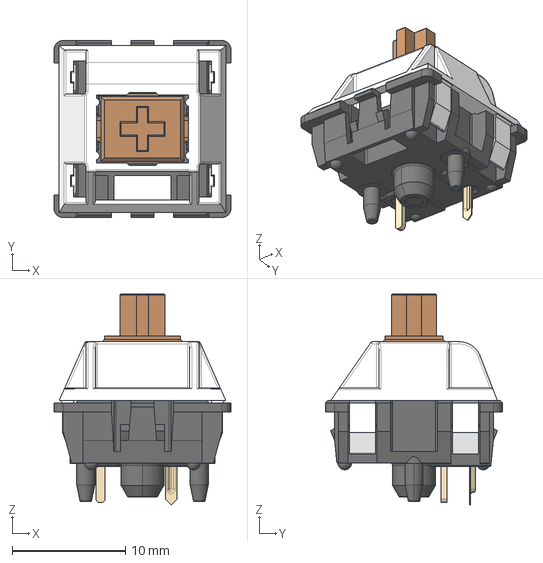
[picture p57: CAD file, 2021-02-02]
3d/SW_Cherry_MX_PCB.step
15.6 x 15.6 x 18.6 mm
