alustig3/kicad-libraries/3d/Stabilizer_Cherry_MX_2u.step

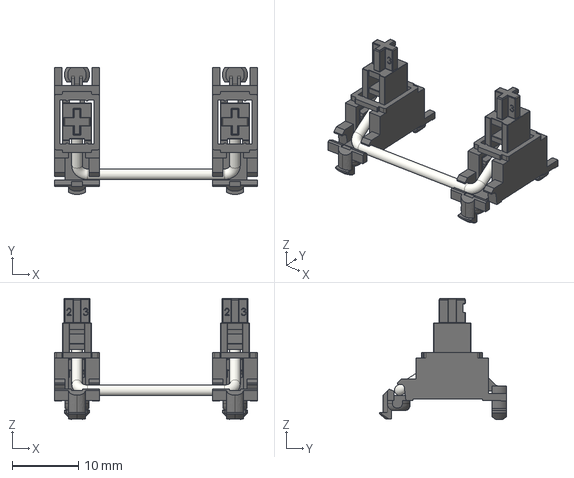
[picture p58: CAD file, 2021-02-02]
3d/Stabilizer_Cherry_MX_2u.step
30.7 x 19.2 x 18.3 mm
