alustig3/kicad-libraries/3d/SWD_socket.step

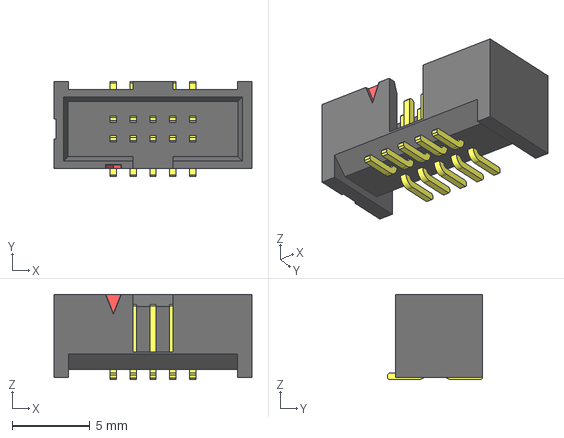
[picture p59: CAD file, 2020-09-14]
3d/SWD_socket.step
12.7 x 6.10 x 5.46 mm
