alustig3/kicad-libraries/3d/B12AP.step

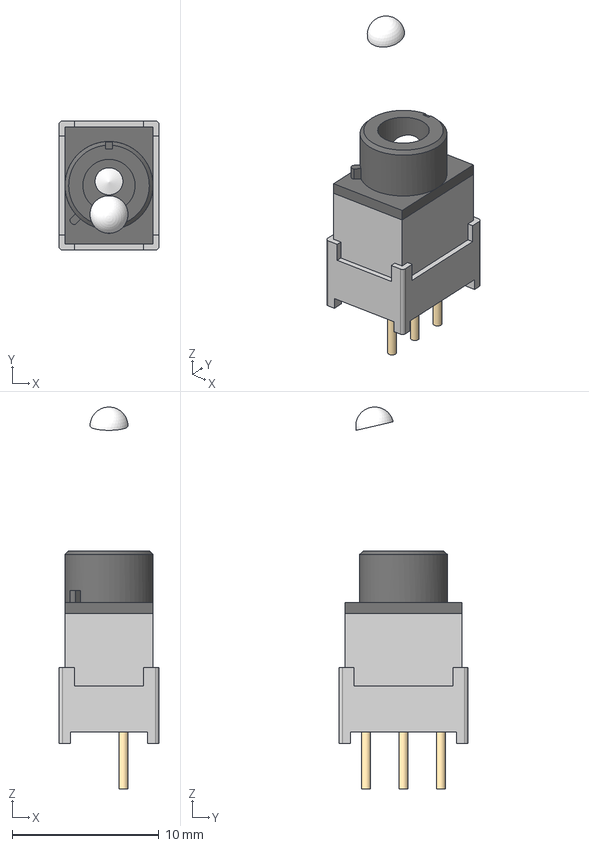
[picture p60: CAD file, 2020-09-14]
3d/B12AP.step
6.81 x 8.79 x 26.0 mm
