alustig3/kicad-libraries/3d/USB_C_TH.step

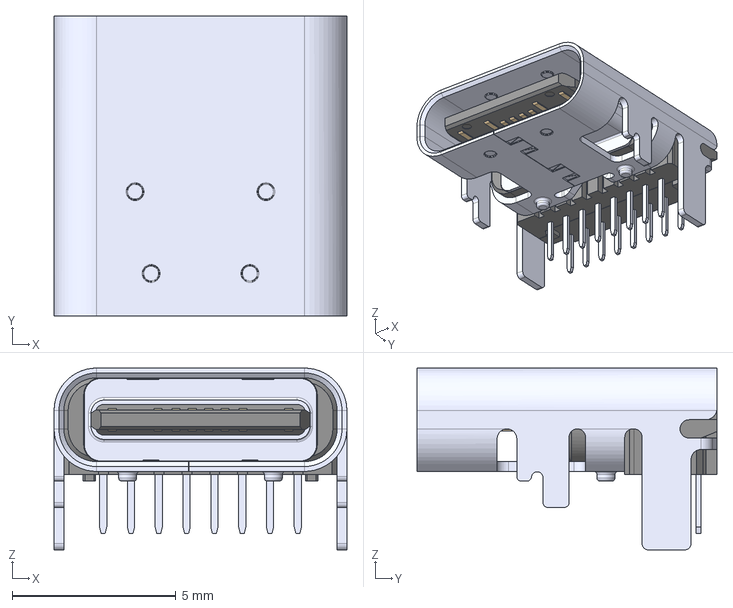
[picture p61: CAD file, 2020-09-14]
3d/USB_C_TH.step
8.95 x 9.17 x 5.56 mm
