alustig3/kicad-libraries/3d/toggle_switch.step

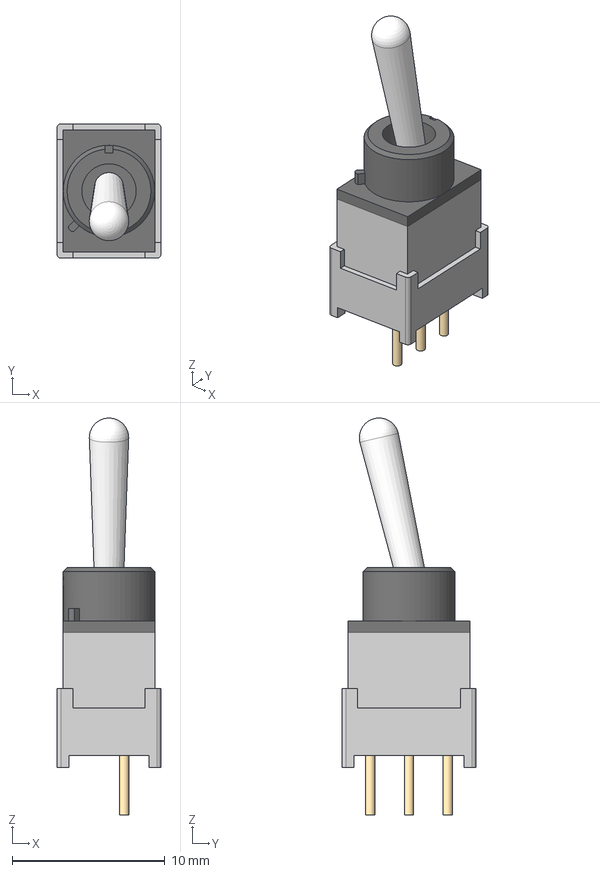
[picture p62: CAD file, 2020-08-11]
3d/toggle_switch.step
6.81 x 8.79 x 26.0 mm
