alustig3/kicad-libraries/3d/trimpot.step

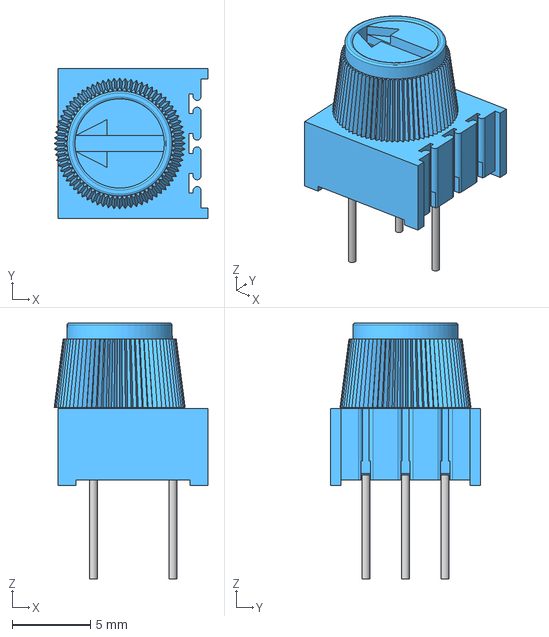
[picture p63: CAD file, 2020-06-06]
3d/trimpot.step
9.83 x 9.58 x 16.4 mm
