alustig3/kicad-libraries/3d/LTC_4727.step

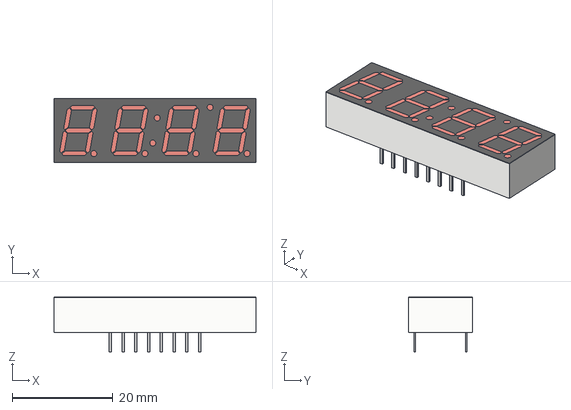
[picture p64: CAD file, 2020-05-06]
3d/LTC_4727.step
40.2 x 12.8 x 10.9 mm
