alustig3/kicad-libraries/3d/RJ45_smd_horizontal.step

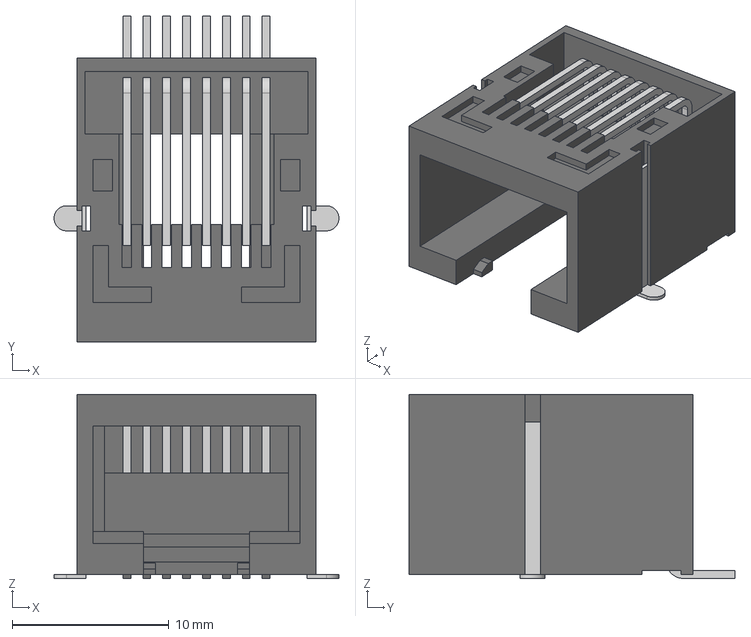
[picture p65: CAD file, 2020-04-24]
3d/RJ45_smd_horizontal.step
18.2 x 20.8 x 11.8 mm
