alustig3/kicad-libraries/3d/reverse_LED.step

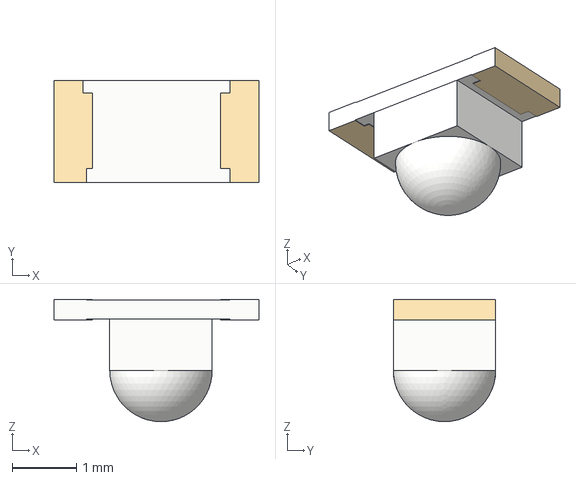
[picture p66: CAD file, 2020-04-03]
3d/reverse_LED.step
3.20 x 1.60 x 1.91 mm
