alustig3/kicad-libraries/3d/DIN_clip.step

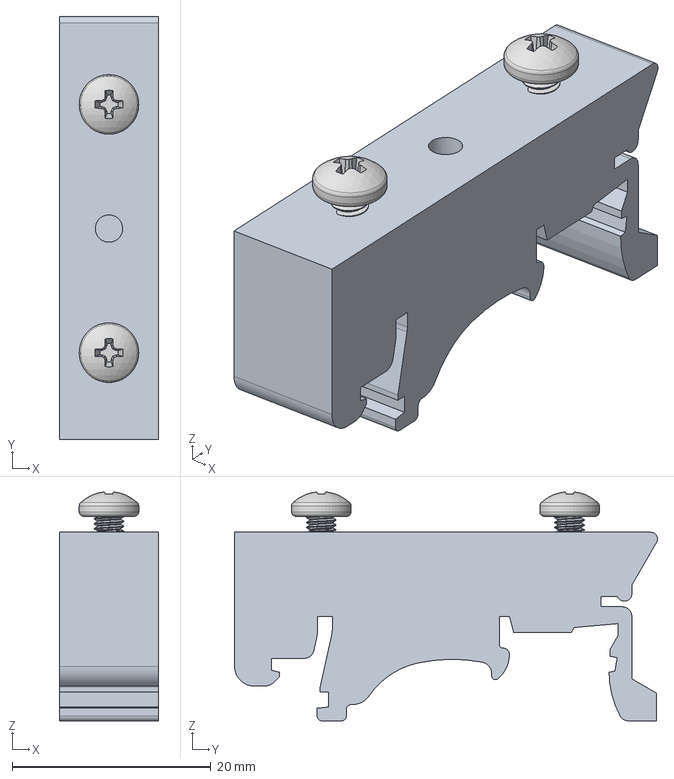
[picture p67: CAD file, 2020-03-24]
3d/DIN_clip.step
10.0 x 42.6 x 23.0 mm
