alustig3/kicad-libraries/3d/audio_jack.step

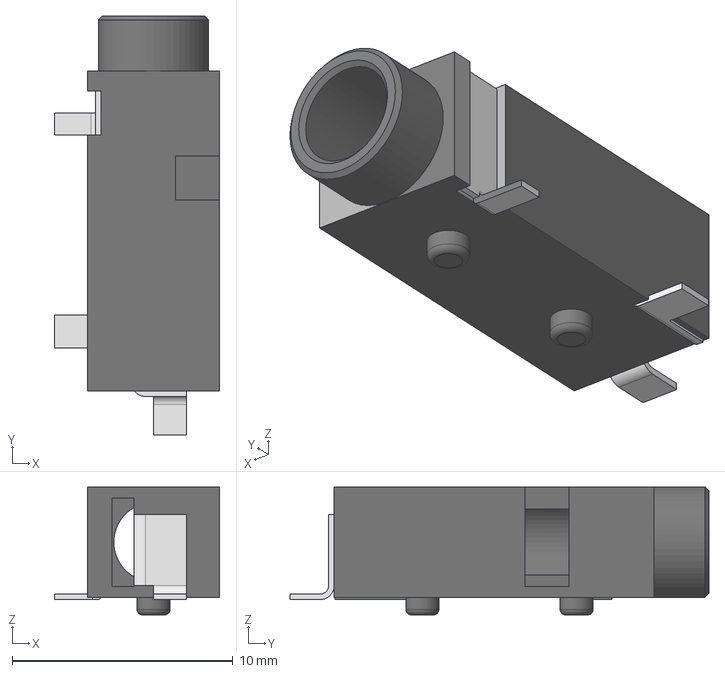
[picture p68: CAD file, 2020-03-04]
3d/audio_jack.step
7.50 x 19.0 x 5.80 mm
