alustig3/kicad-libraries/3d/ICSP.step

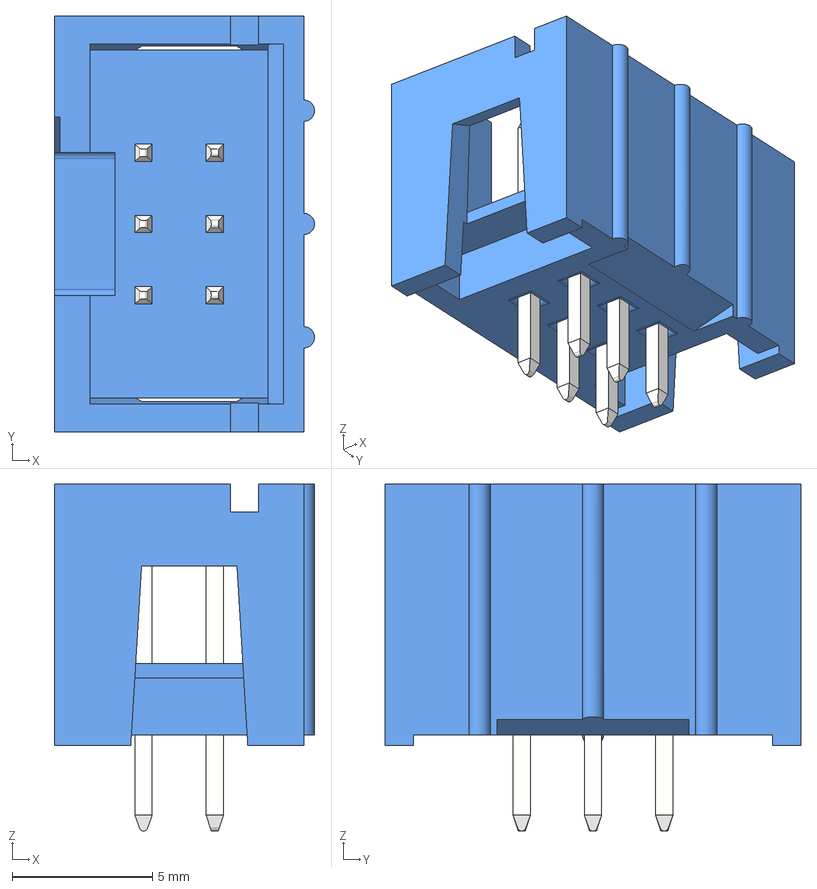
[picture p69: CAD file, 2020-01-20]
3d/ICSP.step
9.27 x 14.8 x 12.4 mm
