alustig3/kicad-libraries/3d/PJ-037A.step

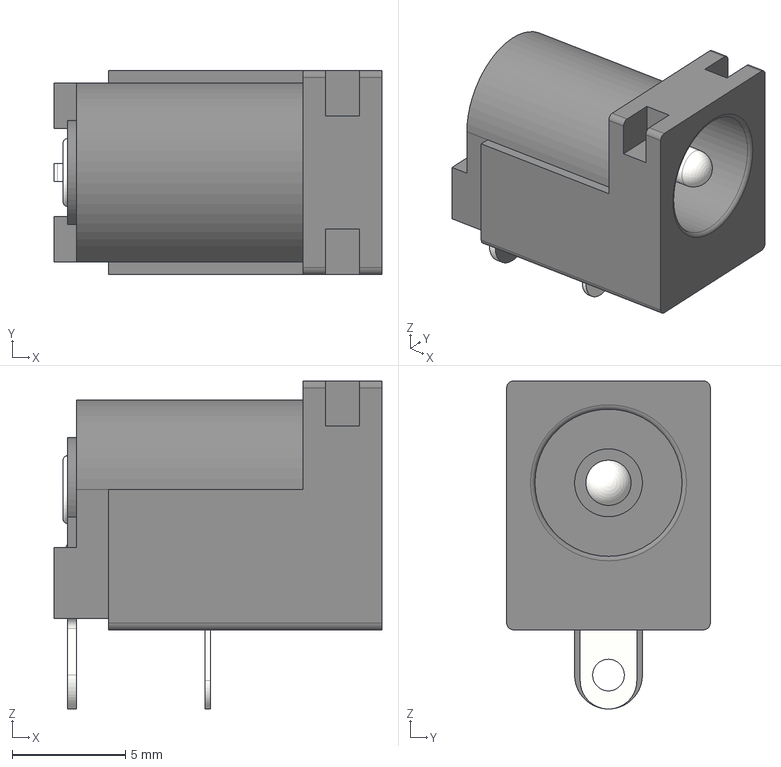
[picture p70: CAD file, 2020-01-17]
3d/PJ-037A.step
14.5 x 9.00 x 14.5 mm
