alustig3/kicad-libraries/3d/B3FS_1000.step

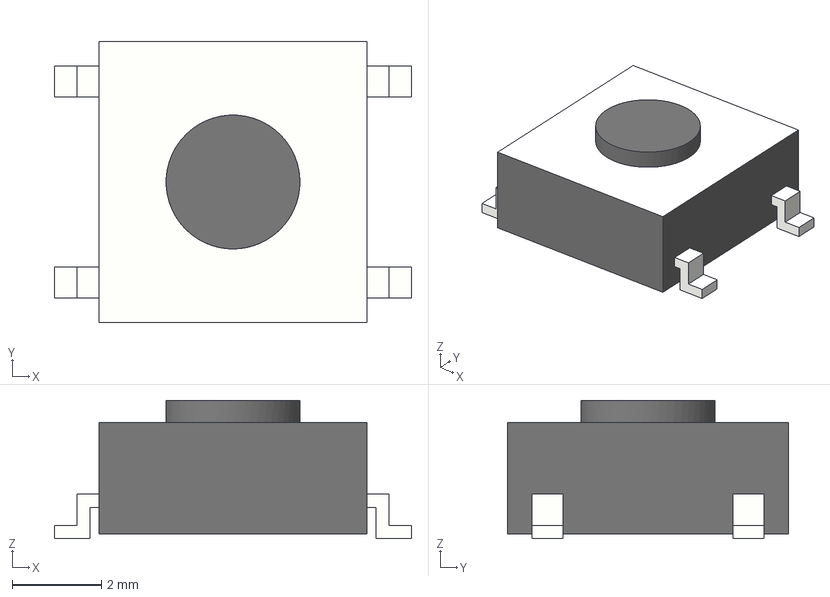
[picture p71: CAD file, 2020-01-17]
3d/B3FS_1000.step
8.00 x 6.30 x 3.10 mm
