alustig3/kicad-libraries/3d/12mm_tactile_smd.step

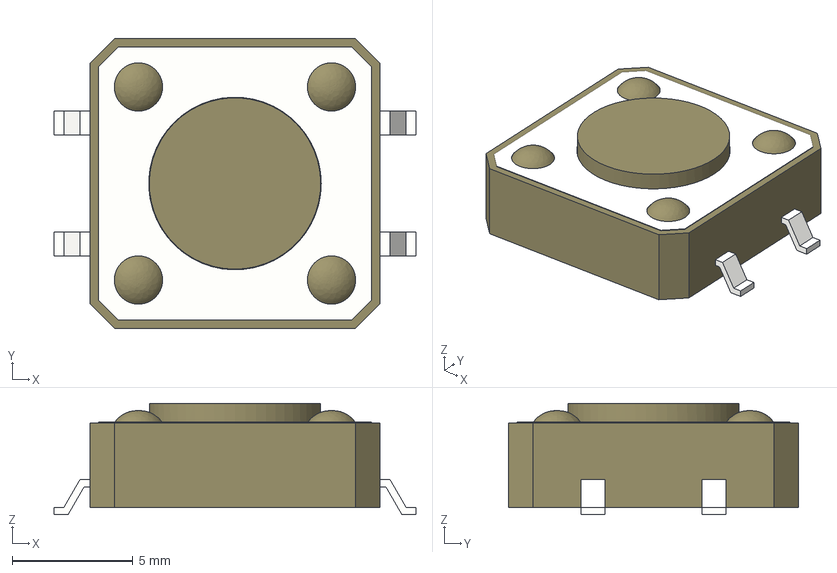
[picture p72: CAD file, 2020-01-17]
3d/12mm_tactile_smd.step
15.0 x 12.0 x 4.60 mm
