alustig3/kicad-libraries/3d/RJ45_smd_vertical.step

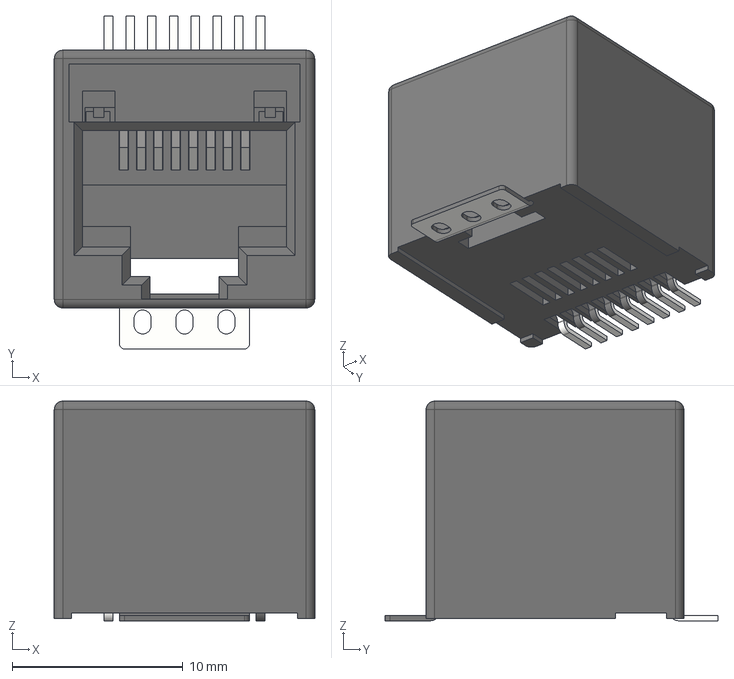
[picture p73: CAD file, 2020-01-16]
3d/RJ45_smd_vertical.step
15.2 x 19.5 x 12.8 mm
