alustig3/kicad-libraries/3d/DF40HC_4.0_-40DS.stp

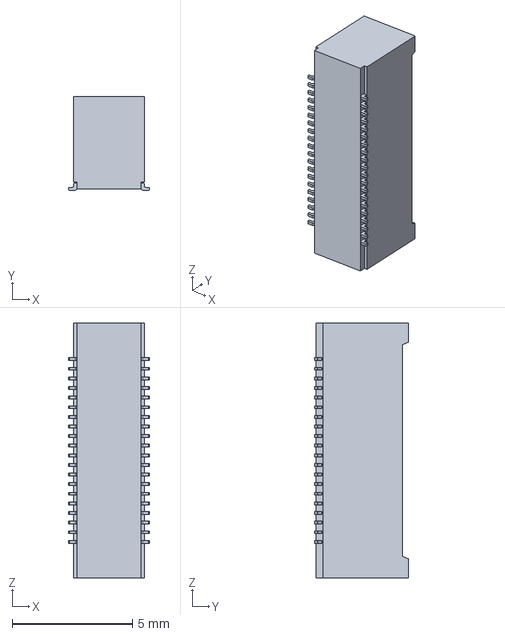
[picture p74: CAD file, 2019-05-08]
3d/DF40HC_4.0_-40DS.stp
3.38 x 3.90 x 10.6 mm
