alustig3/kicad-libraries/(list of files, cad)

Other CAD files:
3d/usb_mirco_horz.step
3d/1825263-1.stp
3d/282834-5.step
3d/69830-008LF.step
3d/731000105.stp
3d/8pos_screw_terminal.step
3d/standoff_nut_10mm.step
3d/standoff_nut_3mm.step
