alustig3/kicad-libraries/(commit log)

2019-05-09 linked symbols to new footprint library name
2019-05-09 added 5v dc dc converter
2019-05-20 Increased mask margin from 2mil to 4 mil on 12port RJ45 footprint
2019-06-06 added components from syringe board. filled in schematic symbol with background color
2019-06-07 Added silent stepstick stepper driver. Added 8pos screw terminal. Renamed pins on feather schematic and footprint.
2019-06-12 SMD RJ45 outline now show up on silkscreen added threaded standoff and tmc2130
2019-06-17 added "W" labels to HS usb pin names. ext_hs is pin 72, not pin 80.
2019-06-19 increase hole size of screw terminal. slightly widen RJ45 mounting tabs
2019-06-20 added screw head outline to DIN clip footprint. added digital potentiometer, 3.3 LDO regulator, and audio amplifier
2019-06-26 fixed linear regulator typo
2019-07-02 added board edge line to microUSB
2019-07-22 changed pyboard footprint outline from silk layer to fab layer
2019-07-26 added 12mm smd switch. organized switches as aliases under the categories of 2pin and 4pin momentary switches added DFPlayer
2019-07-26 added hirose 40pin connector
2019-07-26 changed momentary switch pins to bidirectional
2019-08-01 changed mask clearance on microusb from 3mill to 4 mill. removed extra mounting pads from Hirose D40 connector
2019-08-01 changed mask clearance on micro usb pin pads from 3 mill to 4 mill
2019-08-09 changes to tmc2130 footprint
2019-08-15 updated RJ45 footprint pads to clearance of 0 so that the clearance is now dictated by the board clearance settings
2019-08-15 added standoff footprint
2019-08-22 Added inverter, half bridge driver and pyControl specific RJ45 symbol. Added vertical through hole RJ45 footprint
2019-10-10 added DNP field to din rail adapter
2019-10-30 added teensy 3.2
2019-10-30 added AP7313 LDO regulator
2019-11-01 added teensy with surface mount headers
2019-11-04 made threaded standoff hole slightly larger because the fit was too tight on the prototype PCBs. changed datasheet link to adafruit because digikey doesn't seem to stock the part.
2019-11-04 added dc jack footprint for use with macrofab. normal footprint has to be modified so that macrofab recognizes plated slots
2019-11-07 fixed pin mapping on ap7313. Vin and GND were swapped
2019-11-08 moved screw head outline to fab layer
2020-01-10 Added AVR ISP connector and vertical SMD RJ45
2020-01-15 added board to board joint and mounting hole for 2.5mm screws. outline of SMD RJ45 is now visible on silkscreen layer
2020-01-16 added reverse smd for leds and phototransistor. Added 3d model for vertical SMD RJ45
2020-01-16 fixed 3d model for vertical smd rj45. It was showing up in fusion 360
    [RJ45_smd_vertical.step]
2020-01-17 macrofab dc jack now has edge cuts built in. Had to add in Dwg.User layer then convert to edge cut using text editor https://forum.kicad.info/t/mid-mount-connector-footprint-using-edge-cut-solved/579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
2020-01-17 Added 3d files for all components D-series breakout
    [12mm_tactile_smd.step, B3FS_1000.step, PJ-037A.step]
2020-01-20 added 3d model for ICSP header socket
    [ICSP.step]
2020-01-21 made icsp pin holes larger. corrected RJ45 silkscreen outline to be smaller
2020-02-27 Added RFM69 radio and AP2112 voltage regulator
2020-03-04 added audio jack 2d model
    [audio_jack.step]
2020-03-24 Added DIN clip with screws
    [DIN_clip.step]
2020-04-03 added reverse SMD LED
    [reverse_LED.step]
2020-04-24 3D models for screw terminal, standoff nut, and horizontal RJ45
    [8pos_screw_terminal.step, RJ45_smd_horizontal.step, Standoff_nut.step]
2020-05-06 added 8-digit 7 segment driver (AS1115). added 4-digit 7-segment LED, .39" digit height
    [LTC_4727.step]
2020-06-06 added trimpot and fixed standoff schematic's link to footprint
    [trimpot.step]
2020-08-11 added toggle switch. modified 7 segment display
    [toggle_switch.step]
2020-09-14 Added button and connectors
    Added B12AP momentary switch
    Added SWD 2x5 socket for ARM programming
    Added through hole USB socket
    [B12AP.step, SWD_socket.step, USB_C_TH.step]
2020-11-23 Added mouse-bite footprints
2020-11-23 Added AP63203 voltage regulator
2020-12-09 added Red/green rotary encoder and sparkfun tactile button
2020-12-19 added tag connect footprint
2020-12-19 added RJ25 connector
2020-12-31 fixed rj25 footprint
2021-02-02 added cherry switch 3d models
    [SW_Cherry_MX_PCB.step, Stabilizer_Cherry_MX_2u.step]
2021-02-02 updated mousebite footprint to use dimension layer
2021-02-09 added NKK pc pin toggle switch
    [switch_reinforced_pc_pin.step]
2021-02-10 improved silkscreen
2021-02-14 added eeprom, changed dotstar footprint, fixed tag-connect footprint
2021-03-17 made edge cut lines thicker to fix OSH park rendering bug
2021-06-17 RJ45 vertical through hole update
    updated footprint
    added 3d model
    [vertical RJ45 v1.step]
2021-07-02 added b3u-1000p small momentary switch
    [b3u-1000p.step]
2021-07-02 added PCM12SMTR slide switch
    [PCM12SMTR.step]
2021-07-02 added inductor LQH43CN\
    [LQH43CN100K03.step]
2021-07-03 added molex 2pin micro lock connector
    [2pin_microlock.step]
2021-07-03 added vertical microUSB plug
    [usb_vertical_plug.step]
2021-07-07 RFM69HCW radio module
    [RFM69HCW_315S060_cp.step]
2021-07-08 vertical microUSB socket
    [usb_vertical_socket.step]
2021-07-08 laser diode 5.6mm
    [laser_diode_56.step]
2021-07-15 removed plating from through holes
2021-09-01 added through hole mono jack
2021-09-07 new components for wheel decide v1.4
2021-10-13 updated DIN clip to have plated ring on top
2021-10-13 updated teensy silkscreen
2021-10-13 removed mask on bottom side of DIN clip footprint
2021-11-21 remove copper from battery alignment hole
2021-12-01 updated QT PY silkscreen
    silkscreen no longer crosses pads
2021-12-08 renamed RJ45 through hole footprint
2021-12-08 added BU33SD2MG regulator
    [SSOP5_ROM.step]
2021-12-10 added time of flight sensor VL6180X
    [VL6180X.step]
2021-12-10 added dual channel mosfet BSS138D
2021-12-13 added footprint for esp32-c3-wroom
2021-12-31 made 7-segment display holes smaller
2022-01-29 power only usb c socket
2022-02-28 made usb c legs hole larger
2022-02-28 testing if larger hole accounts for kink in leg
2022-03-22 removed some silkscreen lines
2022-03-23 Revert "made usb c legs hole larger"
    This reverts commit 16c11a5ebfdd76b600faddf86239fdd604c18616.
2022-04-08 added encoder
    [PEC11R-4X15F-S.step]
2022-04-08 toggle switch now type throughole
2022-04-13 extended pads on TOF sensor
2022-04-23 edited courtyard for toggle switches
2022-04-24 lipo charger
2022-06-01 centered footprint
2022-06-01 added qtpy 3d models
    [qtpy_esp32s2.step, qtpy_rp2040.step]
2022-07-14 add 3d models for Cerebro components
    [diode_powermite.step, horz usb.step, resonator.step, usb_mirco_horz.step]
2022-08-28 added cherry mx and jst-ph 3d models that had gone missing
    [JST-S2B-PH-SM4.step]
2022-11-02 added .56" 4 digit 7 segement 3d model
    [4_digit_7_segment_56.step]
2022-11-02 14mm buzzer, set switch, and panel toggle footprints
2022-11-02 kicad 7 changes
2022-12-02 added JST vertical NSH connector, starboard power LED, and power resistor
2022-12-05 toggle and step switch fixes
    - made toggle pads oval and larger
    - fixed step switch NO/NC connections
2022-12-05 added IDC footprints and models
    [69830-008LF.step, IDC_02x04.step]
2022-12-05 added larger reverse mount LED
    [reverse_led_bigger.step]
2022-12-06 added tag connect for esp32-pico
2022-12-06 added max17048 battery monitor
2022-12-22 added keepout to reverse mount LED
2022-12-22 widened panel switch pads
2022-12-24 added RJ45 horizontal through hole with tab on top
2022-12-24 added AL8861 LED driver
2022-12-31 added louder buzzer
    [CMI-1275C-050.step]
2022-12-31 updated .56" 4digit 7 segment 3d model
    [4_digit_7_segment_56.step]
2022-12-31 reverse LED now had solder mask keepouts in addition to copper keepout
2022-12-31 added ringing bell footprint
2023-01-03 added correct 3d model to panel mount toggle switch
    [M2011SS1W03.stp]
2023-01-03 made bell ringing footprint smaller
2023-01-10 updated vertical SH connector
    [BM4B-SRSS-TB.step]
2023-01-10 added 3d model for step switch
    [PB86.step]
2023-01-12 added 5 pin magnetic connector
2023-01-12 extended pads of pico d4 for easier soldering
2023-02-24 fixed through hole size and spacing
2023-05-08 added dot indicator to match LED package dot
2023-06-05 add KB2040
    [KB2040.step]
2023-06-05 fix incorrect pin on KB2040
2023-06-05 12 pin IDC connector
    [IDC_2x06_1.27.stp]
2023-06-05 fixed light leakage that was happening around reverse mount LED
2023-06-24 increase pin 1 indicator for reverse mount LED
2023-07-20 added 12mm tactile model
    [12mm_tactile.stp]
2023-07-20 removed rogue silkscreen line
2023-09-10 added PAM8904 piezo driver
2023-09-10 added 14mm piezo
2024-03-13 adjusted board joint size
2024-03-14 added SMD vibration motor
    [VZ43FM1B8230001L.stp]
2024-04-16 4 pin board joint
2024-04-16 swapped motor pins
2024-04-16 updates to kicad 8
2024-04-23 widen pads of 4pin board to board joint
2024-06-10 add inductor 3d model
    [NR3015T4R7M.STEP]
2024-06-10 grounded mounting hole
2024-06-12 added RJ50
    [SS-651010-A-NF.stp]
2024-06-14 update rj50 footprint
2024-06-14 added RA RJ50
    [SS-641010-A-NF-A111.stp]
2024-07-18 added ESE-22MV21T smd limit switch
    [ESE-22MV21T.step]
2024-07-26 added 4pos idc connector
    [3-2106431-4.step]
2024-08-05 added cutout to vibration motor footprint
2024-08-19 added unexpected maker's esp32 nanos3
2024-08-30 fixed model for tab on top through hole RJ45
    [E5J88-00LJG2-L.stp]
2024-08-30 added LBA716 SSRelay
    [LBA716STR.step]
2024-09-03 adde jst 6y pin vertical PH connector
    [B6B-PH-SM4-TB.step]
2024-09-11 added tmc5072 footprint with slightly longer pads than standard qfn
2024-09-23 add 3pos screw terminal (still need to update 3d model)
2024-09-23 removed top pad from standoff nut
2024-09-23 add horizontal 6pin PH socket
    [S6B-PH-SM4-TB.STEP]
2024-10-28 ad 5pos screw terminal
    [282834-5.step]
2024-10-28 added reverse tft 3d model
    [s3_reverse_tft_feather.step]
2024-11-08 modified pads for DIN and standoff footprints that have large plated through hole
2024-11-19 footprint for vertical PJ012 RJ45
2024-12-13 add CP2102N-QFN20
    [CP2102N-A02-GQFN20R.step]
2024-12-18 added some 3d parts for s3 reverse TFT feather
    [header_male_10pin.stp, header_male_16pin.stp, standoff_nut_10mm.step, standoff_nut_3mm.step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]
2025-06-04 added vertical rj45 3d model
    [RJ45_vertical.step]
2025-12-18 reduce pad size from 1.5 to 1.4mm
2025-12-22 added usb type b
    [USB-B1HSB6.STEP]
2026-02-06 update SWD socket link
2026-02-25 add RGB LED
2026-02-25 add 6.5mm tactile switch
2026-03-03 add right angle SMA connector
    [RFPC-SMA27-F.step]
2026-03-12 add slide switch
    [1825263-1.stp]
2026-04-01 added RA BNC jack
    [731000105.stp]
2026-04-15 update to DIN adapter footprint
2026-04-16 remove unnecessary silkscreen lines
2026-07-08 made holes smaller and anchor pads oval to reduce play
2026-07-08 added 17mm tall tactile switch
    [TS02-66-170-BK-260-LCR-D.step]
2026-07-08 reduce pad hole sizes for less play
2026-07-16 add test point loop 3d model
    [5019.STEP]
2026-07-16 extend transistor array pads for easier hand soldering
2026-08-05 added WSON8 Winbond memory
    [W25Q256JVEIQ.STEP]
2026-08-18 add 3A DCDC converter
    [TSR 3-2450N.STEP]
2026-08-18 add right angle toggle switch
    [RA_toggle.step]
2026-08-19 update m3 standoff footprint
2026-08-19 add right angle m3 screw mount
    [7790.step]
2026-09-21 enlarged pad holes and flipped pin order
2026-09-21 updated footprint to have correct shoulder and toggle dimensions
2026-09-29 RA toggle footprint updates
2026-09-30 added KMR621NG small tactile button
    [KMR621NGLFS.step]
2026-10-02 added DPDT dip switch CAS-D20TB
    [CAS-D20TB.stp]
