alustig3/kicad-libraries/(notices)

Notices in the files:
3d/SS-641010-A-NF-A111.stp:
FILE_NAME( 'C:/Users/KMIROS~1/AppData/Local/Temp/psolqas_2196_24.stp', '2022-01-10T15:07:46', ( 'License CC BY-ND 4.0' ), ( 'CADENAS' ), ' ', 'PARTsolutions', ' ' );
3d/IDC_02x04.step:
author */ ('License CC BY-ND 4.0'),
